danielfu11/exoseat/ProjectPlanning/Diagrams/Architecture_Diagram.jpg

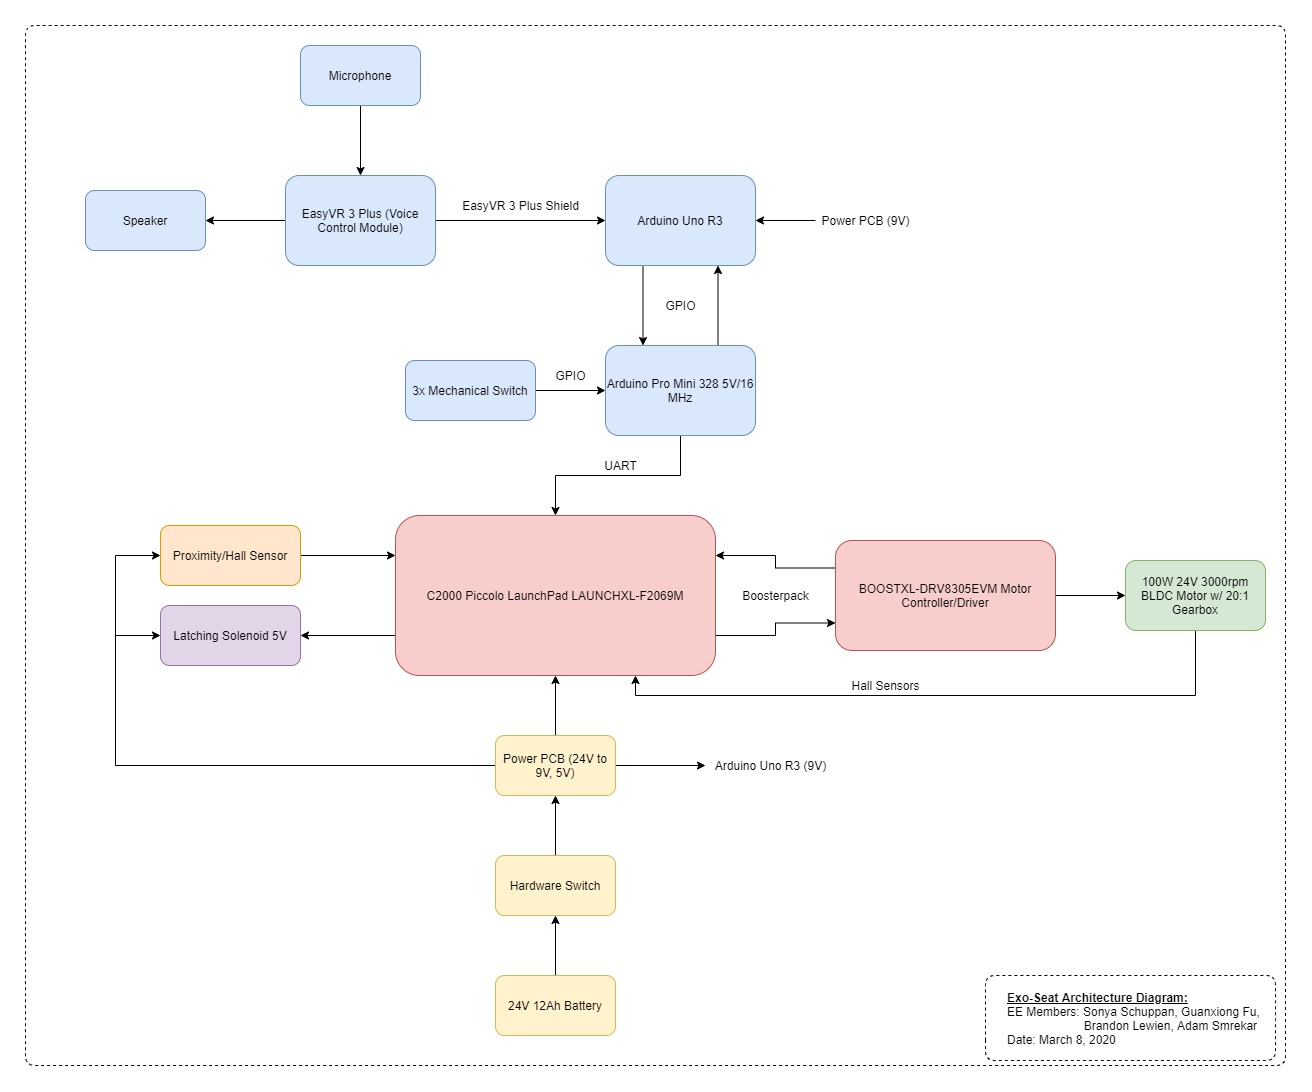
ProjectPlanning/Diagrams/Architecture_Diagram.jpg
