danielfu11/exoseat/ProjectPlanning/Diagrams/SystemStateMachine.PNG

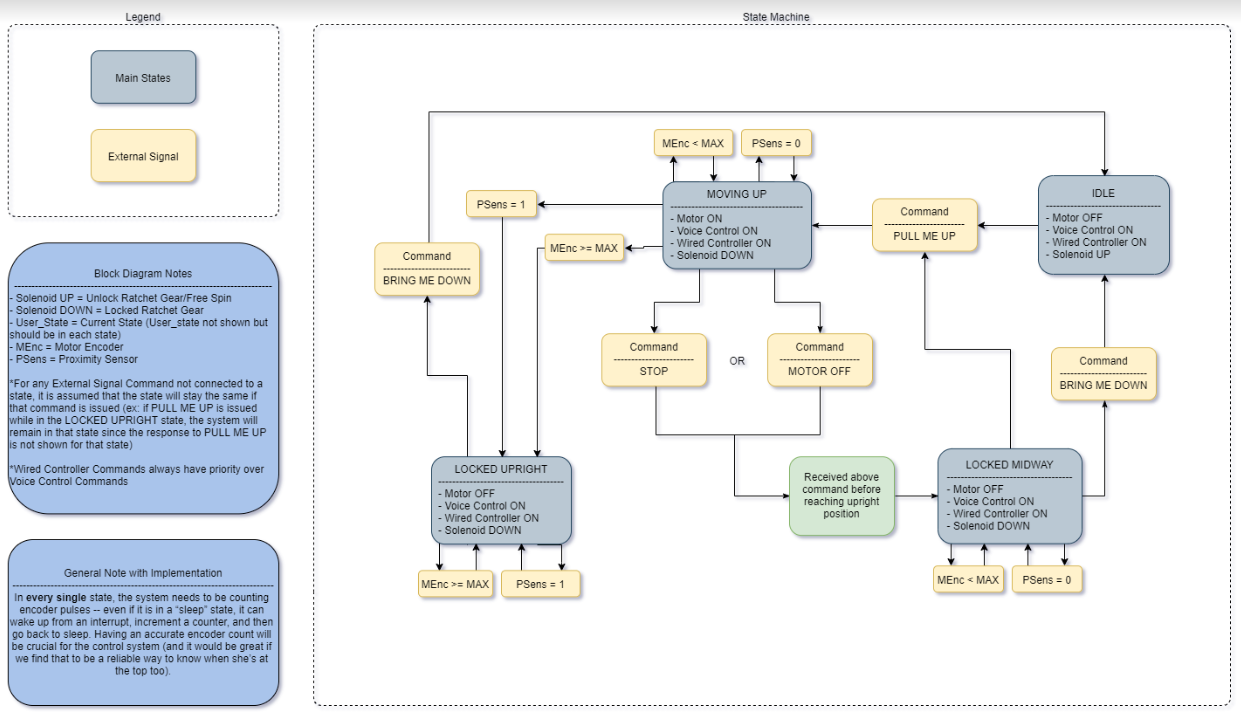
ProjectPlanning/Diagrams/SystemStateMachine.PNG
