danielfu11/exoseat/ProjectPlanning/Diagrams/TrapezoidalCommutationFlowDiagram.PNG

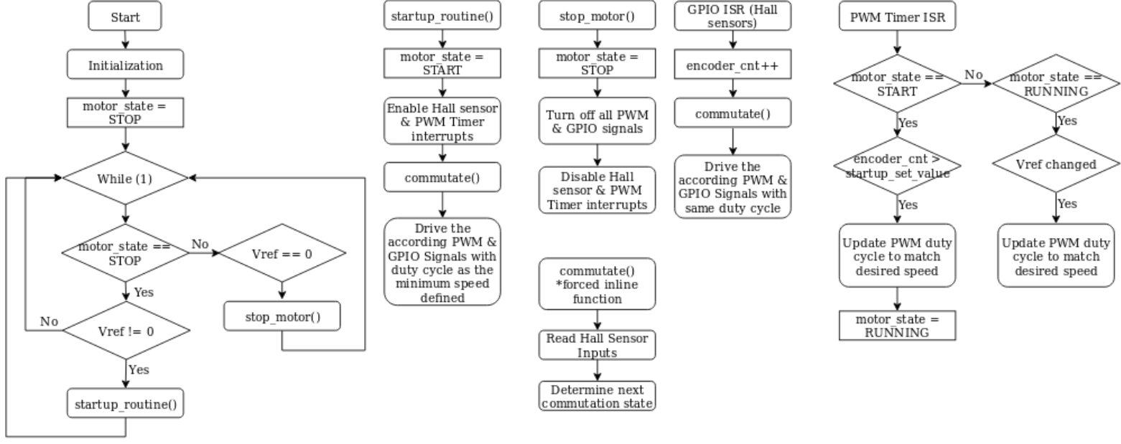
ProjectPlanning/Diagrams/TrapezoidalCommutationFlowDiagram.PNG
