danielfu11/exoseat/ProjectPlanning/Financial/Team_31_Budget_Tracker.xlsx

Sheet: ACTUAL
Design Center Colorado |  |  |  |  |  |  |  |  |  |  |  |  |  | yes | Procurement Card
Team Budget Tracker |  |  |  |  |  |  |  |  |  |  |  |  |  | no | Staff Member
 |  |  |  |  |  |  |  |  |  |  |  |  |  |  | Reimbursement Request
 |  |  |  | Funding Total |  |  |  |  |  |  |  |  |  |  | Campus labs
 |  |  |  | CU Provided | $324.00
Team #: | 31 |  |  | Initial Funding | $200.00
Sponsor: | Tensentric |  |  | Subsequent Funding | $2109.00
Financial Manager: | Adam Smrekar |  |  | Other Funding Sources
Budget Remaining: | $51.55
Sponsor Total Purchased: | $818.66
Project Total Spent: | $3166.90
Date of Purchase | Amount | Which funds? | Vendor | Brief description of item (s) purchased | Business Purpose - Please be detailed. i.e. How does this purchase benefit your project? What will the item be used for? | Website (If applicable) | Purchased via Pcard, Staff Member, in campus labs, or Reimbursement? | Discount/Donation provided by sponsor or vendor? Explain | Receipt Attached to Concur? | If Unit >$150, Budget Justification Uploaded to D2L? | Any tax charged? | What Section was it in the 'BUDGET' tab? | Notes
2019-10-07 | $27.99 | EEF | Amazon | Leamai Inflatable Posture Brace. Inflatable posture corrector back brace. Medical device to correct posture for upper back and shoulders. | Allows us to prototype a potential back support solution for our client Cindy. This is a cost effective and practical solution to help with back support for our client who sits in a wheelchair all day. | https://www.amazon.com/Inflatable-Posture-Corrector-Pressure-Shoulders/dp/B077XQ2M1W | Staff Member | N/A | No | N/A | No | Testing
2019-10-07 | $23.97 | EEF | eBay | Back and shoulder posture correction brace. Has two high-strength support plates. Has X-shaped cross adjustment correction belt. | Allows us to prototype a potential back support solution for our client Cindy. This is a cost effective and practical solution to help with back support for our client who sits in a wheelchair all day. | https://www.ebay.com/itm/Back-Posture-Correction-Shoulder-Corrector-Support-Brace-Belt-Therapy-Men-Women-/303081311477 | Staff Member | N/A | No | N/A | No | Testing
2019-10-07 | $18.54 | EEF | Home Depot | 2x 3 in. Zinc-Plated Fixed Single Pulley | Our design for the wheelchair involves attaching a harness with a rope(or other) to a motor with 2 pulleys. These pulleys will be used for prototyping. | https://www.homedepot.com/p/National-Hardware-3-in-Zinc-Plated-Fixed-Single-Pulley-N220-020/204722014 | Staff Member | N/A | No | N/A | No | Testing
2019-10-07 | $8.95 | EEF | Sparkfun | Flex Sensor. Function of this sensor is when the sensor is flexed, the resistance across the sensor increases. | Prototype option for giving feedback of when and how much client has fallen forward in the chair. Would be used on back. This will allow for better control over the electrical system. | https://www.sparkfun.com/products/10264 | Staff Member | N/A | No | N/A | No | Testing
2019-10-07 | $8.50 | EEF | Sparkfun | Straight bar load cell (also known as strain gauge). Able to translate up to 10kg of force on the straight bar into an electrical signal. | Prototype option for figuring out the amount of force a client is applying to the harness. A potential prototype like this will be used to give feedback about what is going on with the client in the harness to help better control the electrical system. | https://www.sparkfun.com/products/13329 | Staff Member | N/A | No | N/A | No | Testing
2019-10-07 | $15.95 | EEF | Sparkfun | 9 Degrees of Freedom IMU. Motion-sensing system-in-a-chip. Houses a 3-axis accelerometer, 3-axis gyroscope, and 3-axis magnetometer. | Prototype option to allow for feedback of what the client is doing to the harness. Allows for better control of the electrical system. | https://www.sparkfun.com/products/13284 | Staff Member | N/A | No | N/A | No | Testing
2019-10-07 | $12.95 | EEF | Sparkfun | Wheel Encoder Kit. Add-on to a wheel to help measure speed or distance. | Allows us to control how many rotations the motor should do when the motor is helping pull the client back into the correct position or to away from the correct position. | https://www.sparkfun.com/products/12629 | Staff Member | N/A | No | N/A | No | Testing
2019-10-15 | $4.75 | EEF | Sparkfun | Hall-Effect non-latched sensor. Holding a magnet near the sensor will cause the output pin to toggle. | Will be used to detect when the harness is at the top of the wheel chair. | https://www.sparkfun.com/products/14709 | Staff Member | N/A | No | N/A | No | Testing
2019-10-26 | $11.99 | EEF | Amazon | Protoboards. 36 pieces double sided PCB prototype boards in 5 different sizes. | Used for as the board to test out electrical circuits with various functions like the motor driver | https://www.amazon.com/AUSTOR-Prototype-Universal-Protoboard-Electronic/dp/B074X2GDH2 | Procurement Card | N/A | Yes | N/A | No | Testing
2019-10-25 | $38.29 | EEF | 18650 Battery Store | Bason BO-4 Battery Charger. 4 bay compact battery charger | Needed to charge batteries | https://www.18650batterystore.com/Basen-p/basen-bo-4.htm | Procurement Card | 5% Off, discount code | Yes | N/A | No | Testing
2019-10-25 | $70.28 | EEF | Arrow | FIT0185 Brushless DC Motor. Metal DC Geared Motor w/Encoder | Used for prototyping. Having motors is a key part of our design. | https://www.arrow.com/en/products/fit0185/dfrobot | Procurement Card | Discount code | Yes | N/A | No | Testing
2019-10-30 | $19.00 | EEF | Sparkfun | N-Channel MOSFET 60V 30A | Used for motor driver circuit. | https://www.sparkfun.com/products/10213 | Procurement Card | N/A | Yes | N/A | No | Testing
2019-10-30 | $1.95 | EEF | Sparkfun | Jumper Wires - Connected 6" (M/F, 20 Pack) | Wires used for electrical circuits. Will be used for testing. | https://www.sparkfun.com/products/12794 | Procurement Card | N/A | Yes | N/A | No | Testing
2019-10-30 | $1.95 | EEF | Sparkfun | Jumper Wires - Connected 6" (M/M, 20 Pack) | Wires used for electrical circuits. Will be used for testing. | https://www.sparkfun.com/products/12795 | Procurement Card | N/A | Yes | N/A | No | Testing
2019-10-30 | $1.95 | EEF | Sparkfun | Jumper Wires - Connected 6" (F/F, 20 Pack) | Wires used for electrical circuits. Will be used for testing. | https://www.sparkfun.com/products/12796 | Procurement Card | N/A | Yes | N/A | No | Testing
2019-11-07 | $18.95 | EEF | McMaster-Carr | L Series Timing Belt | Used as the timing belt for the gears in motor box. | https://www.mcmaster.com/6484k146 | Procurement Card | N/A | Yes | N/A | No | Testing
2019-11-08 | $44.51 | EEF | Misumi | Rotary shaft – straight | Used in the gear/motor box. | https://us.misumi-ec.com/vona2/detail/110300086920/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 | Procurement Card | N/A | Yes | N/A | No | Testing
2019-11-08 | $59.92 | EEF | Misumi | Idler Pulleys - Flat - Flanged | Pulleys used to hold the straps. | https://us.misumi-ec.com/vona2/detail/110300412670/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 | Procurement Card | N/A | Yes | N/A | No | Testing
2019-11-08 | $36.79 | EEF | Digikey | Solenoid Push Pulse 5V (Latching) | Need a way of releasing the harness/straps from ratchet so a potential option is to use a latching solenoid to allow harness to free spin or stay in place. | https://www.digikey.com/product-detail/en/delta-electronics/DSMS-0730-05/1144-1315-ND/5214006 | Procurement Card | N/A | Yes | N/A | No | Testing
2019-11-14 | $49.95 | EEF | Sparkfun | EasyVR 3 Plus Shield for Arduino. Voice recognition with the EasyVR 3 Plus Module, Arduino Shield Adapter, Microphone, and headers. | One of the potential voice control modules that the user will use to interact with the electrical parts of the project. | https://www.sparkfun.com/products/15453 | Procurement Card | N/A | Yes | N/A | No | Testing
Iteration 1
2019-12-28 | $5.84 | EEF | McMaster-Carr | T-Slotted Framing, Single 4-Slot Rail, Silver, 1" High x 1" Wide, Solid, 1' Long | Used for motor box housing. Motor box holds all the main components for this project. | https://www.mcmaster.com/47065t101-47065T411 | Procurement Card | N/A | Yes | N/A | No | Iteration 1/Manufacturing
2019-12-28 | $20.84 | EEF | McMaster-Carr | Silver Corner Bracket, 1" Long for 1" High Rail T-Slotted Framing | Used for motor box housing. Motor box holds all the main components for this project. | https://www.mcmaster.com/47065t236 | Procurement Card | N/A | Yes | N/A | No | Iteration 1/Manufacturing
2019-12-28 | $23.00 | EEF | McMaster-Carr | T-Slotted Framing, End-Feed Nut with Flanged-Button Head, 1/4"-20 Thread Size, Packs of 4 | Used for motor box housing. Motor box holds all the main components for this project. | https://www.mcmaster.com/47065t142 | Procurement Card | N/A | Yes | N/A | No | Iteration 1/Manufacturing
2019-12-28 | $46.42 | EEF | McMaster-Carr | Multipurpose 6061 Aluminum 90 Degree Angle with Round Edge, 1/4" Thickness, 4" High x 4" Wide Outside, 1' Long | Used for motor box housing. Motor box holds all the main components for this project. | https://www.mcmaster.com/8982k63-8982K631 | Procurement Card | N/A | Yes | N/A | No | Iteration 1/Manufacturing
2019-12-28 | $6.79 | EEF | McMaster-Carr | 7 Piece Ball-End Hex L-Key Set | Tools to screw in hex screws | https://www.mcmaster.com/5709a51 | Procurement Card | N/A | Yes | N/A | No | Iteration 1/Manufacturing
2019-12-28 | $10.38 | EEF | McMaster-Carr | L Series Timing Belt, Trade No. 150L050 | Used in motor box. Used between gears of motor and a shaft that holds rope. | https://www.mcmaster.com/6484k145 | Procurement Card | N/A | Yes | N/A | No | Iteration 1/Manufacturing
2019-12-28 | $0.95 | EEF | McMaster-Carr | Multipurpose 6061 Aluminum, 1/8" Thick x 1" Wide, 1/2 Feet Long | Used in/for motor box. Motor box holds all the main components for this project. | https://www.mcmaster.com/8975k578 | Procurement Card | N/A | Yes | N/A | No | Iteration 1/Manufacturing
2019-12-28 | $0.80 | EEF | McMaster-Carr | Light Duty Dry-Running Nylon Sleeve Bearing for 1/4" Shaft Diameter and 3/8" Housing ID, 1/2" Long | Used in/for motor box. Motor box holds all the main components for this project. | https://www.mcmaster.com/6389k113 | Procurement Card | N/A | Yes | N/A | No | Iteration 1/Manufacturing
2019-12-28 | $27.22 | EEF | McMaster-Carr | Rotary Shaft, 303 Stainless Steel, 1/2" Diameter, 12" Long | Used in/for motor box. Motor box holds all the main components for this project. | https://www.mcmaster.com/8364t5 | Procurement Card | N/A | Yes | N/A | No | Iteration 1/Manufacturing
2019-12-28 | $5.03 | EEF | McMaster-Carr | Easy-to-Machine 303 Stainless Steel Bar, 1/8" Thick, 1/2" Wide, 1/2 Feet Long | Used in/for motor box. Motor box holds all the main components for this project. | https://www.mcmaster.com/9084k96-9084K969 | Procurement Card | N/A | Yes | N/A | No | Iteration 1/Manufacturing
2019-12-28 | $18.88 | EEF | McMaster-Carr | Oil-Embedded SAE 841 Bronze Sleeve Bearing for 15 mm Shaft Diameter and 19 mm Housing ID, 16 mm Long | Used in/for motor box. Motor box holds all the main components for this project. | https://www.mcmaster.com/6658k27 | Procurement Card | N/A | Yes | N/A | No | Iteration 1/Manufacturing
2019-12-28 | $10.14 | EEF | McMaster-Carr | Shipping | Shipping |  | Procurement Card | N/A | Yes | N/A | No | Iteration 1/Manufacturing | Order was originally charged with tax. I had that order refunded and a new invoice was made without tax.
2019-12-28 | $29.21 | EEF | Misumi | Shaft Collars - D Shape, Split 1-1/4" | Used to hold motor box. Motor box holds all the main components for this project. | U-SSCDN1.25 | Procurement Card | N/A | Yes | N/A | No | Iteration 1/Manufacturing
2019-12-28 | $51.90 | EEF | Misumi | Shaft Collars - D Shape, Split 1" | Used to hold motor box. Motor box holds all the main components for this project. | U-SSCDN1.00 | Procurement Card | N/A | Yes | N/A | No | Iteration 1/Manufacturing
2019-12-28 | $32.32 | EEF | Misumi | Shaft Collars - D Shape, 10 mm | Used to hold motor box. Motor box holds all the main components for this project. | SDNA10 | Procurement Card | N/A | Yes | N/A | No | Iteration 1/Manufacturing
2019-12-28 | $41.52 | EEF | Misumi | Shaft Collars - D Shape, 20 mm | Used to hold motor box. Motor box holds all the main components for this project. | SDNA20 | Procurement Card | N/A | Yes | N/A | No | Iteration 1/Manufacturing
2019-12-28 | $48.04 | EEF | Misumi | Both Ends Threaded Precision Linear Shaft | Used in/for motor box. Motor box holds all the main components for this project. | SFAM15-50-F15-B10-P12-T15-S10-Q12 | Procurement Card | N/A | Yes | N/A | No | Iteration 1/Manufacturing
2020-01-09 | $29.21 | EEF | Misumi | Shaft Collars - D Shape, Split 1-1/4" | Used to hold motor box. Motor box holds all the main components for this project. | U-SSCDN1.25 | Procurement Card | N/A | No | N/A | No | Iteration 1/Manufacturing | This part was in 2 seperate orders due to 1 in-stock at the time of original order
2019-12-28 | $23.09 | EEF | Misumi | Shipping | Shipping |  | Procurement Card | N/A | Yes | N/A | No | Iteration 1/Manufacturing
2019-12-28 | $12.19 | EEF | Misumi | Shipping | Shipping |  | Procurement Card | N/A | Yes | N/A | No | Iteration 1/Manufacturing | Since some products were shipped from different locations, they split the price of shipping
2020-01-09 | $25.54 | EEF | Misumi | Shipping | Shipping |  | Procurement Card | N/A | No | N/A | No | Iteration 1/Manufacturing
2019-12-28 | $58.24 | EEF | Midwest Steel and Aluminum | Metal Plates -> || 6061 T6 ALUMINUM SHEET .125: W: 12" L: 12" || || 6061 T6 ALUMINUM SHEET .125: W: 11.5625" L: 11.5625" || || 6061 T6 ALUMINUM SHEET .125: W: 4.5625" L: 11.5625" || || 6061 T6 ALUMINUM SHEET .125: W: 3.5625" L: 11.5625" || | Used in/for motor box. Motor box holds all the main components for this project. | https://www.midweststeelsupply.com/store/6061aluminumsheet | Procurement Card | N/A | Yes | N/A | No | Iteration 1/Manufacturing | Issues with getting billing address on the invoice. Account had correct billing address. Didn't receive invoice until requested and found out about this issue and they wouldn't change it saying the order is closed.
2019-12-28 | $11.64 | EEF | Midwest Steel and Aluminum | Shipping | Shipping |  | Procurement Card | N/A | Yes | N/A | No | Iteration 1/Manufacturing
2019-12-30 | $37.44 | EEF | sdp-si | 440C Stainless Steel/ABEC 3 Ball Bearing Lubricated with Oil | Used in/for motor box. Motor box holds all the main components for this project. | http://shop.sdp-si.com/catalog/product/?id=A%207Y55-P11250 | Procurement Card | N/A | Yes | N/A | No | Iteration 1/Manufacturing
2019-12-30 | $31.92 | EEF | sdp-si | 1/2 in. ID, 3-29/32 in. High Standard Duty Set Screw Type Diamond Flange Mounting Block | Used in/for motor box. Motor box holds all the main components for this project. | http://shop.sdp-si.com/catalog/product/?id=BBXBLK-UFL2018S | Procurement Card | N/A | Yes | N/A | No | Iteration 1/Manufacturing | Invoice has name Designatronics Inc instead of SDP-SI
2019-12-30 | $23.93 | EEF | sdp-si | Shipping | Shipping |  | Procurement Card | N/A | Yes | N/A | No | Iteration 1/Manufacturing | For billing address on invoice, it can't have the correct attn. It uses Company Name instead
2019-12-29 | $31.04 | EEF | Online Metals | Bearing Housing -> || 0.75" x 5" Aluminum Rectangle Bar 6061-T6511-Extruded: Thickness: 0.75", Width: 5", Size: 4.5" || | Used in/for motor box. Motor box holds all the main components for this project. | https://www.onlinemetals.com/en/buy/aluminum-rectangle-bar-6061-t6511-extruded?checkbox=on&sort=name-asc | Procurement Card | N/A | Yes | N/A | No | Iteration 1/Manufacturing
2019-12-29 | $10.00 | EEF | Online Metals | Shipping | Shipping |  | Procurement Card | N/A | Yes | N/A | No | Iteration 1/Manufacturing
2020-01-09 | $19.93 | EEF | Grainger | Shaft Extender Kit,For Use With 1/2" Dia. Motor Shafts | Attaches to the motor | https://www.grainger.com/product/12N975?RIID=54198286875&GID=&mid=EMT-_-10339122-_-OrderConfirmation-_-Item | Procurement Card | N/A | Yes | N/A | No | Iteration 1/Manufacturing
2020-01-09 | $0.00 | EEF | Grainger | Shipping | Shipping |  | Procurement Card | N/A | Yes | N/A | No | Iteration 1/Manufacturing
2020-01-31 | $10.19 | EEF | McMaster-Carr | D-Profile Rotary Shaft, D-Profile Ends, 1045. Carbon Steel, 1/2" Diameter, 12" Long | Used in/for motor box. Motor box holds all the main components for this project. | https://www.mcmaster.com/8632t7 | Procurement Card | N/A | Yes | N/A | No | Iteration 1/Manufacturing
2020-01-31 | $7.31 | EEF | McMaster-Carr | D-Profile Rotary Shaft, D-Profile Ends, 1045 Carbon Steel, 1/2" Diameter, 6" Long | Used in/for motor box. Motor box holds all the main components for this project. | https://www.mcmaster.com/8632t134 | Procurement Card | N/A | No | N/A | No | Iteration 1/Manufacturing | Not Currently Payed because Misumi double charged and made the balance of the order go low
2020-01-31 | $8.39 | EEF | McMaster-Carr | Shipping | Shipping |  | Procurement Card | N/A | No | N/A | No | Iteration 1/Manufacturing
 | $0.00 |  |  |  |  |  | Procurement Card |  |  |  |  | Iteration 1/Manufacturing
2019-12-23 | $610.27 | EEF | ato | 100W 24V 3000rpm BLDC Motor w/ 20:1 Planetary Gearbox and 100W 24V 3000rpm BLDC Motor | Used to allow user's torso to move different positions in the wheelchair. | https://www.ato.com/100w-bldc-motor | Procurement Card | 5% Discount | Yes | Yes | No | Iteration 1/Manufacturing
2019-12-23 | $106.00 | EEF | ato | Custom: Gearbox output shaft length of 25mm and shaft diameter of 0.5 ”(12.97mm) for above motor with planetary gearbox | Custom part for motor w/ gearbox to fit necessary dimensions |  | Procurement Card | N/A | Yes | Yes | No | Iteration 1/Manufacturing | Since this was a custom part, they charged extra for original purchase. This is tied with the order of both of ATO's Brushless DC Motors. On invoice, there is a charge and a partial refund due to we not needing another extra custom part.
2019-12-23 | $0.00 | EEF | ato | Shipping | Shipping |  | Procurement Card | N/A | Yes | N/A | No | Iteration 1/Manufacturing
2019-12-27 | $298.90 | EEF | BixPower | 24V 12Ah Lithium Ion Battery | Used to power the electrical system | https://www.bixpower.com/24V-10-4Ah-Battery-BX2493H-p/bat-bx2493h.htm | Procurement Card | N/A | Yes | Yes | No | Iteration 1/Manufacturing
2019-12-27 | $16.08 | EEF | BixPower | Shipping | Shipping |  | Procurement Card | N/A | Yes | N/A | No | Iteration 1/Manufacturing
2020-01-09 | $27.80 | EEF | Digikey | Solenoid Push Pulse 5V (Latching) | Need a way of releasing the harness/straps from ratchet so a potential option is to use a latching solenoid to allow harness to free spin or stay in place. | https://www.digikey.com/product-detail/en/delta-electronics/DSMS-0730-05/1144-1315-ND/5214006 | Procurement Card | N/A | Yes | N/A | No | Iteration 1/Manufacturing
2020-01-09 | $0.88 | EEF | Digikey | CAP, CERM, 1 µF, 16 V, +/- 10%, X7R, 0603 | Used for custom circuit motor driver. Motor driver interfaces between circuit and motor. Part of EE Capstone requirement is to have a custom PCB, so we chose this circuit to do. | https://www.digikey.com/product-detail/en/kemet/C0603C105K4RACTU/399-7847-1-ND/3471570 | Procurement Card | N/A | Yes | N/A | No | Iteration 1/Manufacturing
2020-01-09 | $3.04 | EEF | Digikey | CAP, CERM, 0.047uF, 100V, +/-10%, X7R, 0603 | Used for custom circuit motor driver. Motor driver interfaces between circuit and motor. | https://www.digikey.com/product-detail/en/kemet/C0603C473K1RACTU/399-9096-1-ND/3522613 | Procurement Card | N/A | Yes | N/A | No | Iteration 1/Manufacturing
2020-01-09 | $8.75 | EEF | Digikey | CAP, CERM, 1 µF, 50 V, +/- 10%, X7R, 0603 | Used for custom circuit motor driver. Motor driver interfaces between circuit and motor. | https://www.digikey.com/product-detail/en/taiyo-yuden/UMK107AB7105KA-T/587-3247-6-ND/3660108 | Procurement Card | N/A | Yes | N/A | No | Iteration 1/Manufacturing
2020-01-09 | $12.79 | EEF | Digikey | CAP, CERM, 4.7 µF, 50 V, +/- 10%, X7R, 1206 | Used for custom circuit motor driver. Motor driver interfaces between circuit and motor. | https://www.digikey.com/product-detail/en/murata-electronics/GRM31CR71H475KA12L/490-6521-6-ND/3846734 | Procurement Card | N/A | Yes | N/A | No | Iteration 1/Manufacturing
2020-01-09 | $1.00 | EEF | Digikey | CAP, CERM, 0.1 µF, 16 V, +/- 5%, X7R, 0603 | Used for custom circuit motor driver. Motor driver interfaces between circuit and motor. | https://www.digikey.com/product-detail/en/kemet/C0603C104J4RACTU/399-1097-1-ND/411372 | Procurement Card | N/A | Yes | N/A | No | Iteration 1/Manufacturing
2020-01-09 | $0.41 | EEF | Digikey | CAP, CERM, 1000pF, 16V, +/-10%, X7R, 0603 | Used for custom circuit motor driver. Motor driver interfaces between circuit and motor. | https://www.digikey.com/product-detail/en/walsin-technology-corporation/0603B102K160CT/1292-1378-1-ND/9355382 | Procurement Card | N/A | Yes | N/A | No | Iteration 1/Manufacturing
2020-01-09 | $14.55 | EEF | Digikey | CAP, CERM, 2.2 µF, 100 V, +/- 10%, X7R, 1210 | Used for custom circuit motor driver. Motor driver interfaces between circuit and motor. | https://www.digikey.com/product-detail/en/murata-electronics/GRM32ER72A225KA35L/490-3385-1-ND/702926 | Procurement Card | N/A | Yes | N/A | No | Iteration 1/Manufacturing
2020-01-09 | $8.59 | EEF | Digikey | CAP, AL, 330 µF, 50 V, +/- 20%, 0.3 ohm, SMD | Used for custom circuit motor driver. Motor driver interfaces between circuit and motor. | https://www.digikey.com/product-detail/en/panasonic-electronic-components/EEE-FT1H331AP/PCE5026CT-ND/2652081 | Procurement Card | N/A | Yes | N/A | No | Iteration 1/Manufacturing
2020-01-09 | $9.32 | EEF | Digikey | CAP, CERM, 22 µF, 10 V, +/- 10%, X7R, 1206 | Used for custom circuit motor driver. Motor driver interfaces between circuit and motor. | https://www.digikey.com/product-detail/en/murata-electronics/GRM31CR71A226KE15L/490-5309-1-ND/2039088 | Procurement Card | N/A | Yes | N/A | No | Iteration 1/Manufacturing
2020-01-09 | $0.55 | EEF | Digikey | CAP, CERM, 2200pF, 16V, +/-10%, X7R, 0603 | Used for custom circuit motor driver. Motor driver interfaces between circuit and motor. | https://www.digikey.com/product-detail/en/yageo/CC0603KRX7R7BB222/311-3652-1-ND/8024741 | Procurement Card | N/A | Yes | N/A | No | Iteration 1/Manufacturing
2020-01-09 | $1.35 | EEF | Digikey | CAP, CERM, 0.33 µF, 16 V, +/- 10%, X7R, 0603 | Used for custom circuit motor driver. Motor driver interfaces between circuit and motor. | https://www.digikey.com/product-detail/en/murata-electronics/GRM188R71C334KA01D/490-3294-1-ND/702835 | Procurement Card | N/A | Yes | N/A | No | Iteration 1/Manufacturing
2020-01-09 | $2.41 | EEF | Digikey | LED, Red, SMD | Used for custom circuit motor driver. Motor driver interfaces between circuit and motor. | https://www.digikey.com/product-detail/en/lite-on-inc/LTST-C170KRKT/160-1415-1-ND/386778 | Procurement Card | N/A | Yes | N/A | No | Iteration 1/Manufacturing
2020-01-09 | $4.58 | EEF | Digikey | Transient Voltage Suppressors, 5 V, TSOP-6 | Used for custom circuit motor driver. Motor driver interfaces between circuit and motor. | https://www.digikey.com/product-detail/en/on-semiconductor/NUP2201MR6T1G/NUP2201MR6T1GOSCT-ND/720939 | Procurement Card | N/A | Yes | N/A | No | Iteration 1/Manufacturing
2020-01-09 | $2.01 | EEF | Digikey | LED, Green, SMD | Used for custom circuit motor driver. Motor driver interfaces between circuit and motor. | https://www.digikey.com/product-detail/en/lite-on-inc/LTST-C171GKT/160-1423-1-ND/386792 | Procurement Card | N/A | Yes | N/A | No | Iteration 1/Manufacturing
2020-01-09 | $3.86 | EEF | Digikey | Diode, Schottky, 100 V, 1 A, SOD-123FL | Used for custom circuit motor driver. Motor driver interfaces between circuit and motor. | https://www.digikey.com/product-detail/en/on-semiconductor/MBR1H100SFT3G/MBR1H100SFT3GOSCT-ND/3462287 | Procurement Card | N/A | Yes | N/A | No | Iteration 1/Manufacturing
2020-01-09 | $3.22 | EEF | Digikey | Terminal Block, 5 mm, 2x1, Tin, TH | Used for custom circuit motor driver. Motor driver interfaces between circuit and motor. | https://www.digikey.com/products/en?keywords=TB001-500-02BE | Procurement Card | N/A | Yes | N/A | No | Iteration 1/Manufacturing
2020-01-09 | $4.31 | EEF | Digikey | Terminal Block, 5 mm, 3x1, Tin, TH | Used for custom circuit motor driver. Motor driver interfaces between circuit and motor. | https://www.digikey.com/products/en?keywords=TB001-500-03BE | Procurement Card | N/A | Yes | N/A | No | Iteration 1/Manufacturing
2020-01-09 | $11.10 | EEF | Digikey | Inductor, Shielded Drum Core, Ferrite, 15 µH, 1.1 A, 0.122 ohm, SMD | Used for custom circuit motor driver. Motor driver interfaces between circuit and motor. | https://www.digikey.com/product-detail/en/eaton-electronics-division/SD53-150-R/513-1458-1-ND/1555607 | Procurement Card | N/A | Yes | N/A | No | Iteration 1/Manufacturing
2020-01-09 | $27.06 | EEF | Digikey | MOSFET, N-CH, 60 V, 28 A, SON 5x6mm | Used for custom circuit motor driver. Motor driver interfaces between circuit and motor. | https://www.digikey.com/product-detail/en/texas-instruments/CSD18540Q5B/296-41076-1-ND/5181337 | Procurement Card | N/A | Yes | N/A | No | Iteration 1/Manufacturing
2020-01-09 | $0.31 | EEF | Digikey | RES, 10k ohm, 5%, 0.1W, 0603 | Used for custom circuit motor driver. Motor driver interfaces between circuit and motor. | https://www.digikey.com/product-detail/en/vishay-dale/CRCW060310K0JNEA/541-10KGCT-ND/1179393 | Procurement Card | N/A | Yes | N/A | No | Iteration 1/Manufacturing
2020-01-09 | $0.31 | EEF | Digikey | RES, 100 ohm, 5%, 0.1W, 0603 | Used for custom circuit motor driver. Motor driver interfaces between circuit and motor. | https://www.digikey.com/product-detail/en/vishay-dale/CRCW0603100RJNEA/541-100GCT-ND/1179345 | Procurement Card | N/A | Yes | N/A | No | Iteration 1/Manufacturing
2020-01-09 | $6.68 | EEF | Digikey | RES SMD 0.007 OHM 1% 3W 2512 | Used for custom circuit motor driver. Motor driver interfaces between circuit and motor. | https://www.digikey.com/product-detail/en/bourns-inc/CRE2512-FZ-R007E-3/CRE2512-FZ-R007E-3CT-ND/4900096 | Procurement Card | N/A | Yes | N/A | No | Iteration 1/Manufacturing
2020-01-09 | $0.31 | EEF | Digikey | RES, 330 ohm, 5%, 0.1W, 0603 | Used for custom circuit motor driver. Motor driver interfaces between circuit and motor. | https://www.digikey.com/product-detail/en/vishay-dale/CRCW0603330RJNEA/541-330GCT-ND/1179357 | Procurement Card | N/A | Yes | N/A | No | Iteration 1/Manufacturing
2020-01-09 | $0.23 | EEF | Digikey | RES, 62.0 k, 1%, 0.1 W, 0603 | Used for custom circuit motor driver. Motor driver interfaces between circuit and motor. | https://www.digikey.com/product-detail/en/yageo/RC0603FR-0762KL/311-62.0KHRCT-ND/730283 | Procurement Card | N/A | Yes | N/A | No | Iteration 1/Manufacturing
2020-01-09 | $0.23 | EEF | Digikey | RES, 4.99 k, 1%, 0.1 W, 0603 | Used for custom circuit motor driver. Motor driver interfaces between circuit and motor. | https://www.digikey.com/product-detail/en/yageo/RC0603FR-074K99L/311-4.99KHRCT-ND/730166 | Procurement Card | N/A | Yes | N/A | No | Iteration 1/Manufacturing
2020-01-09 | $0.31 | EEF | Digikey | RES, 56 ohm, 5%, 0.1W, 0603 | Used for custom circuit motor driver. Motor driver interfaces between circuit and motor. | https://www.digikey.com/product-detail/en/vishay-dale/CRCW060356R0JNEA/541-56GCT-ND/1179339 | Procurement Card | N/A | Yes | N/A | No | Iteration 1/Manufacturing
2020-01-09 | $0.23 | EEF | Digikey | RES, 68.0 k, 1%, 0.1 W, 0603 | Used for custom circuit motor driver. Motor driver interfaces between circuit and motor. | https://www.digikey.com/product-detail/en/yageo/RC0603FR-0768KL/311-68.0KHRCT-ND/730299 | Procurement Card | N/A | Yes | N/A | No | Iteration 1/Manufacturing
2020-01-09 | $0.34 | EEF | Digikey | RES, 20.0 k, 1%, 0.1 W, 0603 | Used for custom circuit motor driver. Motor driver interfaces between circuit and motor. | https://www.digikey.com/product-detail/en/vishay-dale/CRCW060320K0FKEA/541-20.0KHCT-ND/1179956 | Procurement Card | N/A | Yes | N/A | No | Iteration 1/Manufacturing
2020-01-09 | $23.80 | EEF | Digikey | Three Phase Automotive Gate Driver with Three Integrated Current Shunt Amplifiers and Voltage Regulator, PHP0048G | Used for custom circuit motor driver. Motor driver interfaces between circuit and motor. | https://www.digikey.com/product-detail/en/texas-instruments/DRV83055QPHPRQ1/296-44256-1-ND/6109010 | Procurement Card | N/A | Yes | N/A | No | Iteration 1/Manufacturing
2020-01-09 | $11.52 | EEF | Digikey | Wide Input Voltage Range Buck Regulator with High Efficiency Sleep Mode, DDC0006A | Used for custom circuit motor driver. Motor driver interfaces between circuit and motor. | https://www.digikey.com/product-detail/en/texas-instruments/LMR16006XDDCR/296-40293-1-ND/5178170 | Procurement Card | N/A | Yes | N/A | No | Iteration 1/Manufacturing
2020-01-09 | $77.85 | EEF | Digikey | C2000 Piccolo LaunchPad LAUNCHXL-F2069M | Main microcontroller that we are using for this project. These are extra for each EE student to use and/or if any breaks during the development process. | https://www.digikey.com/product-detail/en/texas-instruments/LAUNCHXL-F28069M/296-38832-ND/5138373 | Procurement Card | N/A | Yes | N/A | No | Iteration 1/Manufacturing
2020-01-09 | $9.04 | EEF | Digikey | Tariff |  |  | Procurement Card | N/A | Yes | N/A | No | Iteration 1/Manufacturing
2020-01-09 | $8.99 | EEF | Digikey | Shipping |  |  | Procurement Card | N/A | Yes | N/A | No | Iteration 1/Manufacturing
2020-01-06 | $66.00 | EEF | PCBWay | FR-4 4 Layer Printed Circuit Board for Motor Driver | Custom circuit board to hold all the digikey parts listed above. | https://www.pcbway.com/ | Procurement Card | $5 discount | Yes | N/A | No | Iteration 1/Manufacturing
SPONSOR PROCURED (Fill out ONLY for items purchased on behalf of team directly through Sponsor - not pcard) Only for team tracking purposes. Does not need to be exact if procured on behalf of the team)
Date of Purchase | Amount |  | Vendor | Brief description of item (s) purchased | What Section was it in the 'BUDGET' tab? |  | Notes
2019-10-30 | $17.10 | Tensentric | McMaster Carr | 1/2" Drive Shaft | Testing (Possible Manufacturing) | https://www.mcmaster.com/1346k17
2019-10-30 | $16.28 | Tensentric | McMaster Carr | Aluminum Framing (5 ft) | Testing (Possible Manufacturing) | https://www.mcmaster.com/47065t101
2019-10-30 | $30.48 | Tensentric | McMaster Carr | Bracket for Framing | Testing (Possible Manufacturing) | https://www.mcmaster.com/47065t267
2019-10-30 | $23.00 | Tensentric | McMaster Carr | Framing Fasteners | Testing (Possible Manufacturing) | https://www.mcmaster.com/47065t142
2019-10-30 | $57.99 | Tensentric | McMaster Carr | Ratchet Gear | Testing (Possible Manufacturing) | https://www.mcmaster.com/6283k22
2019-10-30 | $48.48 | Tensentric | McMaster Carr | Pawl | Testing (Possible Manufacturing) | https://www.mcmaster.com/6283k32
2019-10-30 | $3.52 | Tensentric | McMaster Carr | Shoulder Screw - For Pawl | Testing (Possible Manufacturing) | https://www.mcmaster.com/91259a469
2019-10-30 | $4.90 | Tensentric | McMaster Carr | Wing Nut for Shoulder Screw | Testing (Possible Manufacturing) | https://www.mcmaster.com/98671a150
2019-10-30 | $12.30 | Tensentric | McMaster Carr | Shaft Collar Large | Testing (Possible Manufacturing) | https://www.mcmaster.com/9677t21
2019-10-30 | $21.90 | Tensentric | McMaster Carr | Bearing Blocks | Testing (Possible Manufacturing) | https://www.mcmaster.com/5913k61
2019-10-30 | $45.78 | Tensentric | McMaster Carr | Timing Belt Pulley | Testing (Possible Manufacturing) | https://www.mcmaster.com/1304n11
2019-10-30 | $9.37 | Tensentric | McMaster Carr | Timing Belt | Testing (Possible Manufacturing) | https://www.mcmaster.com/6484k144
2019-10-30 | $48.50 | Tensentric | McMaster Carr | Aluminum Side Wall (Sheet Metal) | Testing (Possible Manufacturing) | https://www.mcmaster.com/89015k238
2019-10-30 | $27.21 | Tensentric | McMaster Carr | Aluminum Base (Sheet Metal) | Testing (Possible Manufacturing) | https://www.mcmaster.com/89015k18
2019-10-30 | $6.46 | Tensentric | McMaster Carr | Rotary Spring (Variable Force) | Testing (Possible Manufacturing) | https://www.mcmaster.com/1846n3
2019-10-30 | $15.55 | Tensentric | Digikey | 3-Phase Brushless DC Mtr Driver | Testing (Possible Manufacturing) | https://www.digikey.com/product-detail/en/texas-instruments/DRV8313PWPR/296-40072-1-ND/5177949
2019-10-30 | $29.75 | Tensentric | Digikey | 3-Phase BLDC | Testing | https://www.digikey.com/product-detail/en/texas-instruments/DRV83053QPHPRQ1/296-44255-1-ND/6109009
2019-10-30 | $102.80 | Tensentric | Digikey | Motor Controller | Testing | https://www.digikey.com/products/en?mpart=DRV8313EVM&v=296
2019-11-08 | $64.00 | Tensentric | Flipsky | Motor BLDC | Testing | https://flipsky.net/collections/e-skateboard/products/brushless-dc-motor-h5065-200kv-1650w
Iteration 1
2020-01-16 | $10.92 | Tensentric | Mouser | PCB Headers 2.54mm, 10 Position, 2 Row | Iteration 1/Manufacturing | https://www.mouser.com/ProductDetail/Samtec/SSQ-110-23-F-D
2020-01-28 | $36.55 | Tensentric | Amazon | Back Brace Posture Corrector (XL size : 37" ~ 43") | Iteration 1/Manufacturing | https://www.amazon.com/Brace-Posture-Corrector-Black-Paker/dp/B07WFFNQQF
2020-01-28 | $19.99 | Tensentric | Amazon | Tcare Portable Inflatable Lumbar Support | Iteration 1/Manufacturing | https://www.amazon.com/Tcare-Portable-Inflatable-Support-Cushion/dp/B079BS995B?s=hpc
2020-01-28 | $17.16 | Tensentric | McMaster Carr | highly conductive 6101 aluminum bar: 3 ft length, ¾” width, ⅛” thickness | Iteration 1/Manufacturing | https://www.mcmaster.com/aluminum-bar-stock | 9397T11, 3 ft
2020-01-28 | $32.51 | Tensentric | McMaster Carr | highly conductive 6101 aluminum bar stock: 3 ft length, ¾” width, ¼” thickness | Iteration 1/Manufacturing | https://www.mcmaster.com/aluminum-bar-stock | 9397T12, 3 ft
2020-01-31 | $19.95 | Tensentric | Sparkfun | Pro-Micro 5V/16MHz | Iteration 1/Manufacturing | https://www.sparkfun.com/products/12640
2020-01-31 | $0.75 | Tensentric | Sparkfun | 1N4148 Diode | Iteration 1/Manufacturing | https://www.sparkfun.com/products/8588
2020-01-31 | $7.80 | Tensentric | Sparkfun | Cherry MX Switch Breakout | Iteration 1/Manufacturing | https://www.sparkfun.com/products/13773
2020-01-31 | $5.70 | Tensentric | Sparkfun | Cherry MX Blue Switch | Iteration 1/Manufacturing | https://www.sparkfun.com/products/13834
2020-02-04 | $13.27 | Tensentric | McMaster Carr | Shaft Coupler | Iteration 1/Manufacturing | https://www.mcmaster.com/2424k14
2020-02-04 | $11.68 | Tensentric | McMaster Carr | Aluminum Framing (1 ft) | Iteration 1/Manufacturing | https://www.mcmaster.com/47065t101-47065T411
2020-02-04 | $8.49 | Tensentric | McMaster Carr | M3 Tap | Iteration 1/Manufacturing | https://www.mcmaster.com/8305a12
2020-02-04 | $3.55 | Tensentric | McMaster Carr | Tapping Lubricant | Iteration 1/Manufacturing | https://www.mcmaster.com/1858k75
2020-02-04 | $22.66 | Tensentric | McMaster Carr | Mounting Bearings | Iteration 1/Manufacturing | https://www.mcmaster.com/5913k71
2020-02-04 | $2.00 | Tensentric | McMaster Carr | Key stock 4mm | Iteration 1/Manufacturing | https://www.mcmaster.com/92288a720
2020-02-04 | $2.41 | Tensentric | McMaster Carr | Key stock 5mm | Iteration 1/Manufacturing | https://www.mcmaster.com/92288a725
2020-02-04 | $11.40 | Tensentric | McMaster Carr | Hard Stop | Iteration 1/Manufacturing | https://www.mcmaster.com/3361t73
2020-02-04 | $6.50 | Tensentric | McMaster Carr | Webbing | Iteration 1/Manufacturing | https://www.mcmaster.com/8852t61-8852T416

Sheet: BUDGET
Purchase Plan
Team #: | 31
Sponsor: | Tensentric
Financial Manager: | Adam Smrekar
Team Budget:
Funding Sources:
CU Provided | 200
Other | 2433 | **Does not include funding from Tensentric**
Total Project Funding | 2633
Expense Summary
Phase 1: Testing | $673.83
Phase 2: Iteration 1/Manufacturing | $3152.61 | **Includes some extras that is funding used for all iterations**
Phase 3: Expo | $50.00
Client Interactions | $0.00
Contingency 7% | $271.35
Total Project Estimate | $4147.79
Phase 1: Testing
Item | Description | Vendor | Part No. | Website Link (optional) | Quantity | Price Per Unit | Shipping (Est) | Discount | Total (Est) | Status (i.e. ready, ordered, complete, etc) | Lead Time | Need by | Funded by
Leamai Inflatable Posture Brace | Inflatable posture corrector back brace. Medical device to correct posture for upper back and shoulders. | Amazon |  | https://www.amazon.com/Inflatable-Posture-Corrector-Pressure-Shoulders/dp/B077XQ2M1W | 1 | $22.00 | $5.99 | $0.00 | $27.99 | Complete |  | 2019-10-07 | EEF/CU
Back and shoulder posture correction brace | Has two high-strength support plates. Has X-shaped cross adjustment correction belt. | eBay |  | https://www.ebay.com/itm/Back-Posture-Correction-Shoulder-Corrector-Support-Brace-Belt-Therapy-Men-Women-/303081311477 | 1 | $10.98 | $12.99 | $0.00 | $23.97 | Complete |  | 2019-10-07 | EEF/CU
3 in. Zinc-Plated Fixed Single Pulley | 3 in. Zinc-Plated Fixed Single Pulley | Home Depot |  | https://www.homedepot.com/p/National-Hardware-3-in-Zinc-Plated-Fixed-Single-Pulley-N220-020/204722014 | 2 | $9.27 | $0.00 | $0.00 | $18.54 | Complete |  | 2019-10-07 | EEF/CU
Flex Sensor (2.2") | Function of this sensor is when the sensor is flexed, the resistance across the sensor increases. | Sparkfun |  | https://www.sparkfun.com/products/10264 | 1 | $8.95 | $0.00 | $0.00 | $8.95 | Complete |  | 2019-10-07 | EEF/CU
Straight bar load cell | Also known as strain gauge. Able to translate up to 10kg of force on the straight bar into an electrical signal. | Sparkfun |  | https://www.sparkfun.com/products/13329 | 1 | $8.50 | $0.00 | $0.00 | $8.50 | Complete |  | 2019-10-07 | EEF/CU
9 Degrees of Freedom IMU | Motion-sensing system-in-a-chip. Houses a 3-axis accelerometer, 3-axis gyroscope, and 3-axis magnetometer. | Sparkfun |  | https://www.sparkfun.com/products/13284 | 1 | $15.95 | $0.00 | $0.00 | $15.95 | Complete |  | 2019-10-07 | EEF/CU
Wheel Encoder Kit | Add-on to a wheel to help measure speed or distance. | Sparkfun |  | https://www.sparkfun.com/products/12629 | 1 | $12.95 | $0.00 | $0.00 | $12.95 | Complete |  | 2019-10-07 | EEF/CU
Hall-Effect non-latched sensor | Holding a magnet near the sensor will cause the output pin to toggle. | Sparkfun |  | https://www.sparkfun.com/products/14709 | 5 | $0.95 | $0.00 | $0.00 | $4.75 | Complete |  | 2019-10-15 | EEF/CU
Protoboards | 36 pieces double sided PCB prototype boards in 5 different sizes. | Amazon |  | https://www.amazon.com/AUSTOR-Prototype-Universal-Protoboard-Electronic/dp/B074X2GDH2 | 1 | $11.99 | $0.00 | $0.00 | $11.99 | Complete |  | 2019-10-25 | EEF/CU
Bason BO-4 Battery Charger | 4 bay compact battery charger | 1850 Battery Store |  | https://www.18650batterystore.com/Basen-p/basen-bo-4.htm | 2 | $14.99 | $9.81 | $1.50 | $38.29 | Complete |  | 2019-10-25 | EEF/CU
FIT0185 Brushless DC Motor | Metal DC Geared Motor w/Encoder | Arrow |  | https://www.arrow.com/en/products/fit0185/dfrobot | 2 | $28.94 | $23.98 | $11.58 | $70.28 | Complete |  | 2019-10-25 | EEF/CU
Jumper Wires (M/M, 20 Pack) | Jumper Wires - Connected 6" (M/M, 20 Pack) | Sparkfun |  | https://www.sparkfun.com/products/12795 | 1 | $1.95 | $0.00 | $0.00 | $1.95 | Complete |  | 2019-10-30 | EEF/CU
Jumper Wires (M/F, 20 Pack) | Jumper Wires - Connected 6" (M/F, 20 Pack) | Sparkfun |  | https://www.sparkfun.com/products/12794 | 1 | $1.95 | $0.00 | $0.00 | $1.95 | Complete |  | 2019-10-30 | EEF/CU
Jumper Wires (F/F, 20 Pack) | Jumper Wires - Connected 6" (F/F, 20 Pack) | Sparkfun |  | https://www.sparkfun.com/products/12796 | 1 | $1.95 | $0.00 | $0.00 | $1.95 | Complete |  | 2019-10-30 | EEF/CU
N-Channel MOSFET 60V 30A | N-Channel MOSFET 60V 30A | Sparkfun |  | https://www.sparkfun.com/products/10213 | 20 | $0.95 | $0.00 | $0.00 | $19.00 | Complete |  | 2019-10-30 | EEF/CU
Solenoid Push Pulse 5V (Latching) | Solenoid Push Pulse 5V (Latching) | Digikey |  | https://www.digikey.com/product-detail/en/delta-electronics/DSMS-0730-05/1144-1315-ND/5214006 | 1 | $27.80 | $8.99 | $0.00 | $36.79 | Complete |  | 2019-11-08 | EEF/CU
L Series Timing Belt | L Series Timing Belt | McMaster-Carr | 187L050 | https://www.mcmaster.com/6484k146 | 1 | $0.00 | $0.00 | $0.00 | $0.00 | Complete |  | 2019-11-07 | EEF/CU
Rotary shaft – straight | Rotary shaft – straight | Misumi | NSFHR15-310 | https://us.misumi-ec.com/vona2/detail/110300086920/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 | 1 | $0.00 | $0.00 | $0.00 | $0.00 | Complete |  | 2019-11-08 | EEF/CU
Idler Pulleys - Flat - Flanged | Idler Pulleys - Flat - Flanged | Misumi | TPBSN70-28 | https://us.misumi-ec.com/vona2/detail/110300412670/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 | 4 | $0.00 | $0.00 | $0.00 | $0.00 | Complete |  | 2019-11-08 | EEF/CU
EasyVR 3 Plus Shield for Arduino | Voice Recognition Module | Sparkfun |  | https://www.sparkfun.com/products/15453 | 1 | $49.95 | $0.00 | $0.00 | $49.95 | Complete |  | 2019-11-14 | EEF/CU
1/2" Drive Shaft | 1/2" Drive Shaft | McMaster Carr | 1346K17 | https://www.mcmaster.com/1346k17 | 2 | $0.00 | $0.00 | $0.00 | $0.00 | Complete |  | 2019-10-30 | Tensentric
Aluminum Framing (5 ft) | Aluminum Framing (5 ft) | McMaster Carr | 47065T101 | https://www.mcmaster.com/47065t101 | 1 | $0.00 | $0.00 | $0.00 | $0.00 | Complete |  | 2019-10-30 | Tensentric
Bracket for Framing | Bracket for Framing | McMaster Carr | 47065T267 | https://www.mcmaster.com/47065t267 | 4 | $0.00 | $0.00 | $0.00 | $0.00 | Complete |  | 2019-10-30 | Tensentric
Framing Fasteners | Framing Fasteners | McMaster Carr | 47065T142 | https://www.mcmaster.com/47065t142 | 10 | $0.00 | $0.00 | $0.00 | $0.00 | Complete |  | 2019-10-30 | Tensentric
Ratchet Gear | Ratchet Gear | McMaster Carr | 6283K22 | https://www.mcmaster.com/6283k22 | 1 | $0.00 | $0.00 | $0.00 | $0.00 | Complete |  | 2019-10-30 | Tensentric
Pawl | Pawl | McMaster Carr | 6283K32 | https://www.mcmaster.com/6283k32 | 1 | $0.00 | $0.00 | $0.00 | $0.00 | Complete |  | 2019-10-30 | Tensentric
Shoulder Screw - For Pawl | Shoulder Screw - For Pawl | McMaster Carr | 91259A469 | https://www.mcmaster.com/91259a469 | 1 | $0.00 | $0.00 | $0.00 | $0.00 | Complete |  | 2019-10-30 | Tensentric
Wing Nut for Shoulder Screw | Wing Nut for Shoulder Screw | McMaster Carr | 98671A150 | https://www.mcmaster.com/98671a150 | 1 | $0.00 | $0.00 | $0.00 | $0.00 | Complete |  | 2019-10-30 | Tensentric
Shaft Collar Large | Shaft Collar Large | McMaster Carr | 9677T21 | https://www.mcmaster.com/9677t21 | 1 | $0.00 | $0.00 | $0.00 | $0.00 | Complete |  | 2019-10-30 | Tensentric
Bearing Blocks | Bearing Blocks | McMaster Carr | 5913K61 | https://www.mcmaster.com/5913k61 | 2 | $0.00 | $0.00 | $0.00 | $0.00 | Complete |  | 2019-10-30 | Tensentric
Timing Belt Pulley | Timing Belt Pulley | McMaster Carr | 1304N11 | https://www.mcmaster.com/1304n11 | 2 | $0.00 | $0.00 | $0.00 | $0.00 | Complete |  | 2019-10-30 | Tensentric
Timing Belt | Timing Belt | McMaster Carr | 6484K144 | https://www.mcmaster.com/6484k144 | 1 | $0.00 | $0.00 | $0.00 | $0.00 | Complete |  | 2019-10-30 | Tensentric
Aluminum Side Wall (Sheet Metal) | Aluminum Side Wall (Sheet Metal) | McMaster Carr | 89015K238 | https://www.mcmaster.com/89015k238 | 1 | $0.00 | $0.00 | $0.00 | $0.00 | Complete |  | 2019-10-30 | Tensentric
Aluminum Base (Sheet Metal) | Aluminum Base (Sheet Metal) | McMaster Carr | 89015K18 | https://www.mcmaster.com/89015k18 | 1 | $0.00 | $0.00 | $0.00 | $0.00 | Complete |  | 2019-10-30 | Tensentric
Rotary Spring (Variable Force) | Rotary Spring (Variable Force) | McMaster Carr | 1846N3 | https://www.mcmaster.com/1846n3 | 2 | $0.00 | $0.00 | $0.00 | $0.00 | Complete |  | 2019-10-30 | Tensentric
3-Phase Brushless DC Mtr Driver | 3-Phase Brushless DC Mtr Driver | Digikey |  | https://www.digikey.com/product-detail/en/texas-instruments/DRV8313PWPR/296-40072-1-ND/5177949 | 5 | $3.11 | $0.00 | $0.00 | $15.55 | Complete |  | 2019-10-30 | Tensentric
3-Phase BLDC | 3-Phase BLDC | Digikey |  | https://www.digikey.com/product-detail/en/texas-instruments/DRV83053QPHPRQ1/296-44255-1-ND/6109009 | 5 | $5.95 | $0.00 | $0.00 | $29.75 | Complete |  | 2019-10-30 | Tensentric
Motor Controller | Motor Controller | Digikey |  | https://www.digikey.com/products/en?mpart=DRV8313EVM&v=296 | 1 | $102.80 | $0.00 | $0.00 | $102.80 | Complete |  | 2019-10-30 | Tensentric
Motor BLDC | Motor BLDC | Flipsky |  | https://flipsky.net/collections/e-skateboard/products/brushless-dc-motor-h5065-200kv-1650w | 1 | $64.00 | $0.00 | $0.00 | $64.00 | Complete |  | 2019-11-08 | Tensentric
3-Phase Motor Drive BoosterPack | DRV8305N 3-Phase Motor Drive BoosterPack Evaluation Module | Digikey |  | https://www.digikey.com/product-detail/en/texas-instruments/BOOSTXL-DRV8305EVM/296-43181-ND/5761583 | 1 | $82.03 | $0.00 | $0.00 | $82.03 | Complete |  | 2019-11-20 | Tensentric
C2000 Piccolo LaunchPad Microcontroller | C2000 Piccolo LaunchPad LAUNCHXL-F2069M | Digikey |  | https://www.digikey.com/product-detail/en/texas-instruments/LAUNCHXL-F28069M/296-38832-ND/5138373 | 1 | $25.95 | $0.00 | $0.00 | $25.95 | Complete |  | 2019-11-20 | Tensentric
Phase 2: Iteration 1/Manufacturing (i.e. Bill of Materials)
Item # | Description | Vendor | Part No. | Website Link (optional) | Quantity | Price Per Unit | Shipping (Est) | Discount | Total (Est) | Status (i.e. ready, ordered, complete, etc) | Lead Time | Need by | Funded by
1/2" Drive Shaft | 1/2" Drive Shaft | McMaster Carr | 1346K17 | https://www.mcmaster.com/1346k17 | 2 | $8.55 | $0.00 | $0.00 | $17.10 | Complete |  | 2019-10-30 | Tensentric
Aluminum Framing (5 ft) | Aluminum Framing (5 ft) | McMaster Carr | 47065T101 | https://www.mcmaster.com/47065t101 | 1 | $16.28 | $0.00 | $0.00 | $16.28 | Complete |  | 2019-10-30 | Tensentric
Bracket for Framing | Bracket for Framing | McMaster Carr | 47065T267 | https://www.mcmaster.com/47065t267 | 4 | $7.62 | $0.00 | $0.00 | $30.48 | Complete |  | 2019-10-30 | Tensentric
Framing Fasteners | Framing Fasteners | McMaster Carr | 47065T142 | https://www.mcmaster.com/47065t142 | 10 | $2.30 | $0.00 | $0.00 | $23.00 | Complete |  | 2019-10-30 | Tensentric
Ratchet Gear | Ratchet Gear | McMaster Carr | 6283K22 | https://www.mcmaster.com/6283k22 | 1 | $57.99 | $0.00 | $0.00 | $57.99 | Complete |  | 2019-10-30 | Tensentric
Pawl | Pawl | McMaster Carr | 6283K32 | https://www.mcmaster.com/6283k32 | 1 | $48.48 | $0.00 | $0.00 | $48.48 | Complete |  | 2019-10-30 | Tensentric
Shoulder Screw - For Pawl | Shoulder Screw - For Pawl | McMaster Carr | 91259A469 | https://www.mcmaster.com/91259a469 | 1 | $3.52 | $0.00 | $0.00 | $3.52 | Complete |  | 2019-10-30 | Tensentric
Wing Nut for Shoulder Screw | Wing Nut for Shoulder Screw | McMaster Carr | 98671A150 | https://www.mcmaster.com/98671a150 | 1 | $4.90 | $0.00 | $0.00 | $4.90 | Complete |  | 2019-10-30 | Tensentric
Shaft Collar Large | Shaft Collar Large | McMaster Carr | 9677T21 | https://www.mcmaster.com/9677t21 | 1 | $12.30 | $0.00 | $0.00 | $12.30 | Complete |  | 2019-10-30 | Tensentric
Bearing Blocks | Bearing Blocks | McMaster Carr | 5913K61 | https://www.mcmaster.com/5913k61 | 2 | $10.95 | $0.00 | $0.00 | $21.90 | Complete |  | 2019-10-30 | Tensentric
Timing Belt Pulley | Timing Belt Pulley | McMaster Carr | 1304N11 | https://www.mcmaster.com/1304n11 | 2 | $22.89 | $0.00 | $0.00 | $45.78 | Complete |  | 2019-10-30 | Tensentric
Timing Belt | Timing Belt | McMaster Carr | 6484K144 | https://www.mcmaster.com/6484k144 | 1 | $9.37 | $0.00 | $0.00 | $9.37 | Complete |  | 2019-10-30 | Tensentric
Aluminum Side Wall (Sheet Metal) | Aluminum Side Wall (Sheet Metal) | McMaster Carr | 89015K238 | https://www.mcmaster.com/89015k238 | 1 | $48.50 | $0.00 | $0.00 | $48.50 | Complete |  | 2019-10-30 | Tensentric
Aluminum Base (Sheet Metal) | Aluminum Base (Sheet Metal) | McMaster Carr | 89015K18 | https://www.mcmaster.com/89015k18 | 1 | $27.21 | $0.00 | $0.00 | $27.21 | Complete |  | 2019-10-30 | Tensentric
Rotary Spring (Variable Force) | Rotary Spring (Variable Force) | McMaster Carr | 1846N3 | https://www.mcmaster.com/1846n3 | 2 | $3.23 | $0.00 | $0.00 | $6.46 | Complete |  | 2019-10-30 | Tensentric
L Series Timing Belt | L Series Timing Belt | McMaster-Carr | 187L050 | https://www.mcmaster.com/6484k146 | 1 | $11.27 | $7.68 | $0.00 | $18.95 | Complete |  | 2019-11-07 | EEF/CU
Rotary shaft – straight | Rotary shaft – straight | Misumi | NSFHR15-310 | https://us.misumi-ec.com/vona2/detail/110300086920/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 | 1 | $14.47 | $30.04 | $0.00 | $44.51 | Complete |  | 2019-11-08 | EEF/CU
Idler Pulleys - Flat - Flanged | Idler Pulleys - Flat - Flanged | Misumi | TPBSN70-28 | https://us.misumi-ec.com/vona2/detail/110300412670/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 | 4 | $14.98 | $0.00 | $0.00 | $59.92 | Complete |  | 2019-11-08 | EEF/CU
Harness | Harness | TBD |  | TBD | 1 | $55.00 | $0.00 | $0.00 | $55.00 | Not Ready |  | 2019-01-13 | TBD
Buckles | Buckles | TBD |  | TBD | 1 | $10.00 | $0.00 | $0.00 | $10.00 | Not Ready |  | 2019-01-13 | TBD
Thing Steel Plates | Thing Steel Plates | TBD |  | TBD | 1 | $30.00 | $0.00 | $0.00 | $30.00 | Not Ready |  | 2019-01-13 | TBD
Cooling Material | Cooling Material | TBD |  | TBD | 1 | $35.00 | $0.00 | $0.00 | $35.00 | Not Ready |  | 2019-01-13 | TBD
Sewing Kit | Sewing Kit | TBD |  | TBD | 1 | $8.00 | $0.00 | $0.00 | $8.00 | Not Ready |  | 2019-01-13 | TBD
Extra Material for Loops | Extra Material for Loops | TBD |  | TBD | 1 | $12.00 | $0.00 | $0.00 | $12.00 | Not Ready |  | 2019-01-13 | TBD
3D Printing Materials | 3D Printing Materials | TBD |  | TBD | 1 | $100.00 | $0.00 | $0.00 | $100.00 | Not Ready |  | 2019-01-13 | TBD
D shape SC 1 1/4 | D shape SC 1 1/4 | Misumi | U-SSCDN1.25 | Misumi | 2 | $29.21 | $0.00 | $0.00 | $58.42 | 1x Complete, 1x Ordered |  | 2020-01-13 | EEF
D shape SC 1" | D shape SC 1" | Misumi | U-SSCDN1.00 | Misumi | 2 | $25.95 | $0.00 | $0.00 | $51.90 | Complete |  | 2020-01-13 | EEF
D shape 10 mm | D shape 10 mm | Misumi | SDNA10 | Misumi | 2 | $16.60 | $0.00 | $0.00 | $33.20 | Complete |  | 2020-01-13 | EEF
D shape 20 mm | D shape 20 mm | Misumi | SDNA20 | Misumi | 2 | $20.76 | $0.00 | $0.00 | $41.52 | Complete |  | 2020-01-13 | EEF
t slot | t slot | McMaster-Carr | 47065T101 | https://www.mcmaster.com/47065t101-47065T411 | 1 | $10.00 | $0.00 | $0.00 | $10.00 | Complete |  | 2020-01-13 | EEF
corner bracket | corner bracket | McMaster-Carr | 47065T236 | https://www.mcmaster.com/47065t236 | 4 | $5.21 | $0.00 | $0.00 | $20.84 | Complete |  | 2020-01-13 | EEF
t slot fastener | t slot fastener | McMaster-Carr | 47065T142 | https://www.mcmaster.com/47065t142 | 10 | $2.30 | $0.00 | $0.00 | $23.00 | Complete |  | 2020-01-13 | EEF
top bracket | top bracket | McMaster-Carr | 8982K63 | https://www.mcmaster.com/8982k63-8982K631 | 2 | $23.21 | $0.00 | $0.00 | $46.42 | Complete |  | 2020-01-13 | EEF
metal plates | metal plates | Midwest Supply | N/A | https://www.midweststeelsupply.com/store/6061aluminumsheet | 1 | $0.00 | $0.00 | $0.00 | $0.00 | Complete |  | 2020-01-13 | EEF
allen set | allen set | McMaster-Carr | 5709A51 | https://www.mcmaster.com/5709a51 | 1 | $6.79 | $0.00 | $0.00 | $6.79 | Complete |  | 2020-01-13 | EEF
BEARING | BEARING | sdp-si | A7Y55P11250 | http://shop.sdp-si.com/catalog/product/?id=A%207Y55-P11250 | 2 | $18.72 | $0.00 | $0.00 | $37.44 | Complete |  | 2020-01-13 | EEF
L series timing belt | L series timing belt | McMaster-Carr | 6484K145 | https://www.mcmaster.com/6484k145 | 1 | $10.38 | $0.00 | $0.00 | $10.38 | Complete |  | 2020-01-13 | EEF
bearing housing | bearing housing | Online Metals | N/A | https://www.onlinemetals.com/en/buy/aluminum-rectangle-bar-6061?checkbox=on&sort=name-asc | 2 | $15.51 | $0.00 | $0.00 | $31.02 | Complete |  | 2020-01-13 | EEF
pawl bracket | pawl bracket | McMaster-Carr | 8975K578 | https://www.mcmaster.com/8975k578 | 1 | $0.95 | $0.00 | $0.00 | $0.95 | Complete |  | 2020-01-13 | EEF
bushing | bushing | McMaster-Carr | 6389K113 | https://www.mcmaster.com/6389k113 | 1 | $0.80 | $0.00 | $0.00 | $0.80 | Complete |  | 2020-01-13 | EEF
pulley belt shaft | pulley belt shaft | McMaster-Carr | 8364T5 | https://www.mcmaster.com/8364t5 | 1 | $27.22 | $0.00 | $0.00 | $27.22 | Complete |  | 2020-01-13 | EEF
pulley belt clamp | pulley belt clamp | McMaster-Carr | 9084K96 | https://www.mcmaster.com/9084k96-9084K969 | 1 | $5.03 | $0.00 | $0.00 | $5.03 | Complete |  | 2020-01-13 | EEF
bearing for motor | bearing for motor | sdp-si | N/A | http://shop.sdp-si.com/catalog/product/?id=BBXBLK-UFL2018S | 2 | $15.96 | $0.00 | $0.00 | $31.92 | Complete |  | 2020-01-13 | EEF
stepped shaft | stepped shaft | Misumi | SFAM15-50-F15-B10-P12-T15-S10-Q12 | Misumi | 4 | $12.01 | $0.00 | $0.00 | $48.04 | Complete |  | 2020-01-13 | EEF
sleeve bearing | sleeve bearing | McMaster-Carr | 6658K27 | https://www.mcmaster.com/6658k27 | 8 | $2.36 | $0.00 | $0.00 | $18.88 | Complete |  | 2020-01-13 | EEF
belt | belt | Seattle Fabrics | None | https://www.seattlefabrics.com/34-X630-Nylon-Webbing-75-yard_p_181.html | 8 | $0.75 | $0.00 | $0.00 | $6.00 | To-Order (Don't Order Yet) |  | 2020-01-13 | EEF
d ring | d ring | Seattle Fabrics | None | https://www.seattlefabrics.com/Light-Weight-Welded-D-Rings-in-Nickel-Plated-Steel_p_1074.html | 2 | $0.50 | $0.00 | $0.00 | $1.00 | To-Order (Don't Order Yet) |  | 2020-01-13 | EEF
Shaft Extender Kit | Shaft Extender Kit, For Use With 1/2" Dia. Motor Shafts | Grainger | 12N975 | https://www.grainger.com/product/DAYTON-Shaft-Extender-Kit-12N975 | 1 | $23.98 | $0.00 | $0.00 | $23.98 | Complete |  | 2020-01-13 | EEF
 |  |  |  |  |  | $0.00 | $0.00 | $0.00 | $0.00
 |  |  |  |  |  | $0.00 | $0.00 | $0.00 | $0.00
 |  |  |  |  |  | $0.00 | $0.00 | $0.00 | $0.00
 |  |  |  |  |  | $0.00 | $0.00 | $0.00 | $0.00
 |  |  |  |  |  | $0.00 | $0.00 | $0.00 | $0.00
 |  |  |  |  |  | $0.00 | $0.00 | $0.00 | $0.00
 |  |  |  |  |  | $0.00 | $0.00 | $0.00 | $0.00
 |  |  |  |  |  | $0.00 | $0.00 | $0.00 | $0.00
 |  |  |  |  |  | $0.00 | $0.00 | $0.00 | $0.00
 |  |  |  |  |  | $0.00 | $0.00 | $0.00 | $0.00
 |  |  |  |  |  | $0.00 | $0.00 | $0.00 | $0.00
 |  |  |  |  |  | $0.00 | $0.00 | $0.00 | $0.00
 |  |  |  |  |  | $0.00 | $0.00 | $0.00 | $0.00
 |  |  |  |  |  | $0.00 | $0.00 | $0.00 | $0.00
 |  |  |  |  |  | $0.00 | $0.00 | $0.00 | $0.00
Testing | Testing of Materials + Replacements |  |  |  | 1 | $400.00 | $0.00 | $0.00 | $400.00
100W 12V/24V 3000rpm BLDC Motor | 100W 12V/24V 3000rpm BLDC Motor w/ 70:1 Planetary Gearbox | ato |  | https://www.ato.com/100w-bldc-motor | 1 | $480.14 | $0.00 | $0.00 | $480.14 | Shipped |  | 2020-01-13 | EEF
C2000 Piccolo LaunchPad Microcontroller | C2000 Piccolo LaunchPad LAUNCHXL-F2069M | Digikey |  | https://www.digikey.com/product-detail/en/texas-instruments/LAUNCHXL-F28069M/296-38832-ND/5138373 | 3 | $25.95 | $0.00 | $0.00 | $77.85 | Complete |  | 2019-11-20 | Tensentric
EasyVR 3 Plus Shield for Arduino | Voice Recognition Module | Sparkfun |  | https://www.sparkfun.com/products/15453 | 1 | $49.95 | $0.00 | $0.00 | $49.95 | Complete |  | 2019-11-14 | EEF
24V 12Ah Lithium Ion Battery | 24V 12Ah Lithium Ion Battery | BixPower | KL24H93S.809 | https://www.bixpower.com/24V-10-4Ah-Battery-BX2493H-p/bat-bx2493h.htm | 1 | $289.95 | $0.00 | $0.00 | $289.95 | Complete |  | 2020-01-13 | EEF
Wired Controller PCB | Custom PCB for Wired Controller | TBD |  | TBD | 1 | $0.00 | $0.00 | $0.00 | $0.00 | Not Ready |  | 2020-01-13 | TBD
Extra Electrical Components | Wires, etc | TBD |  | TBD | 1 | $0.00 | $0.00 | $0.00 | $0.00 | Not Ready |  | 2020-01-13 | TBD
Solenoid Push Pulse 5V (Latching) | Solenoid Push Pulse 5V (Latching) | Digikey |  | https://www.digikey.com/product-detail/en/delta-electronics/DSMS-0730-05/1144-1315-ND/5214006 | 2 | $27.80 | $8.99 | $0.00 | $64.59 | Complete |  | 2019-11-08 | EEF/CU
 |  |  |  |  |  | $0.00 | $0.00 | $0.00 | $0.00
 |  |  |  |  |  | $0.00 | $0.00 | $0.00 | $0.00
 |  |  |  |  |  | $0.00 | $0.00 | $0.00 | $0.00
 |  |  |  |  |  | $0.00 | $0.00 | $0.00 | $0.00
 |  |  |  |  |  | $0.00 | $0.00 | $0.00 | $0.00
 |  |  |  |  |  | $0.00 | $0.00 | $0.00 | $0.00
Shipping | Everyone's Shipping |  |  |  | 1 | $150.00 | $0.00 | $0.00 | $150.00
BOOSTXL-DRV8305EVM Parts (Some parts may have different part number due to availability, original part number listed)
C1, C3, C9, C17 | CAP, CERM, 1 µF, 16 V, +/- 10%, X7R, 0603 | Digikey | C1608X7R1C105K | https://www.digikey.com/product-detail/en/tdk-corporation/C1608X7R1C105K080AC/445-1604-1-ND/634399 | 10 | $0.10 | $0.00 | $0.00 | $1.05 | Complete |  | 2020-01-13 | EEF
C2, C7 | CAP, CERM, 0.047uF, 100V, +/-10%, X7R, 0603 | Digikey | C0603C473K1RACTU | https://www.digikey.com/product-detail/en/kemet/C0603C473K1RACTU/399-9096-1-ND/3522613 | 10 | $0.30 | $0.00 | $0.00 | $3.04 | Complete |  | 2020-01-13 | EEF
C4, C5, C6, C20 | CAP, CERM, 1 µF, 50 V, +/- 10%, X7R, 0603 | Digikey | UMK107AB7105KA-T | https://www.digikey.com/product-detail/en/taiyo-yuden/UMK107AB7105KA-T/587-3247-6-ND/3660108 | 10 | $0.17 | $0.00 | $0.00 | $1.75 | Complete |  | 2020-01-13 | EEF
C8 | CAP, CERM, 4.7 µF, 50 V, +/- 10%, X7R, 1206 | Digikey | GRM31CR71H475KA12L | https://www.digikey.com/product-detail/en/murata-electronics/GRM31CR71H475KA12L/490-6521-6-ND/3846734 | 10 | $0.58 | $0.00 | $0.00 | $5.79 | Complete |  | 2020-01-13 | EEF
C10, C11, C12, C22 | CAP, CERM, 0.1 µF, 16 V, +/- 5%, X7R, 0603 | Digikey | C0603C104J4RACTU | https://www.digikey.com/product-detail/en/kemet/C0603C104J4RACTU/399-1097-1-ND/411372 | 10 | $0.10 | $0.00 | $0.00 | $1.00 | Complete |  | 2020-01-13 | EEF
C13, C14, C16 | CAP, CERM, 1000pF, 16V, +/-10%, X7R, 0603 | Digikey | GRM188R71C102KA01D | https://www.digikey.com/product-detail/en/walsin-technology-corporation/0603B102K160CT/1292-1378-1-ND/9355382 | 10 | $0.04 | $0.00 | $0.00 | $0.41 | Complete |  | 2020-01-13 | EEF
C15 | CAP, CERM, 2.2 µF, 100 V, +/- 10%, X7R, 1210 | Digikey | GRM32ER72A225KA35L | https://www.digikey.com/product-detail/en/murata-electronics/GRM32ER72A225KA35L/490-3385-1-ND/702926 | 10 | $1.46 | $0.00 | $0.00 | $14.55 | Complete |  | 2020-01-13 | EEF
C18, C19 | CAP, AL, 330 µF, 50 V, +/- 20%, 0.3 ohm, SMD | Digikey | EEE-FT1H331AP | https://www.digikey.com/product-detail/en/panasonic-electronic-components/EEE-FT1H331AP/PCE5026CT-ND/2652081 | 10 | $0.86 | $0.00 | $0.00 | $8.59 | Complete |  | 2020-01-13 | EEF
C21 | CAP, CERM, 22 µF, 10 V, +/- 10%, X7R, 1206 | Digikey | GRM31CR71A226KE15L | https://www.digikey.com/product-detail/en/murata-electronics/GRM31CR71A226KE15L/490-5309-1-ND/2039088 | 10 | $0.85 | $0.00 | $0.00 | $8.48 | Complete |  | 2020-01-13 | EEF
C23, C24, C25 | CAP, CERM, 2200pF, 16V, +/-10%, X7R, 0603 | Digikey | GRM188R71C222KA01D | https://www.digikey.com/product-detail/en/yageo/CC0603KRX7R7BB222/311-3652-1-ND/8024741 | 10 | $0.06 | $0.00 | $0.00 | $0.55 | Complete |  | 2020-01-13 | EEF
C26 | CAP, CERM, 0.33 µF, 16 V, +/- 10%, X7R, 0603 | Digikey | GRM188R71C334KA01D | https://www.digikey.com/product-detail/en/murata-electronics/GRM188R71C334KA01D/490-3294-1-ND/702835 | 10 | $0.14 | $0.00 | $0.00 | $1.35 | Complete |  | 2020-01-13 | EEF
D1 | LED, Red, SMD | Digikey | LTST-C170KRKT | https://www.digikey.com/product-detail/en/lite-on-inc/LTST-C170KRKT/160-1415-1-ND/386778 | 10 | $0.24 | $0.00 | $0.00 | $2.41 | Complete |  | 2020-01-13 | EEF
D2 | Transient Voltage Suppressors, 5 V, TSOP-6 | Digikey | NUP4201MR6T1G | https://www.digikey.com/product-detail/en/on-semiconductor/NUP2201MR6T1G/NUP2201MR6T1GOSCT-ND/720939 | 10 | $0.46 | $0.00 | $0.00 | $4.58 | Complete |  | 2020-01-13 | EEF
D3 | LED, Green, SMD | Digikey | LTST-C171GKT | https://www.digikey.com/product-detail/en/lite-on-inc/LTST-C171GKT/160-1423-1-ND/386792 | 10 | $0.20 | $0.00 | $0.00 | $2.01 | Complete |  | 2020-01-13 | EEF
D4 | Diode, Schottky, 100 V, 1 A, SOD-123FL | Digikey | MBR1H100SFT3G | https://www.digikey.com/product-detail/en/on-semiconductor/MBR1H100SFT3G/MBR1H100SFT3GOSCT-ND/3462287 | 10 | $0.39 | $0.00 | $0.00 | $3.86 | Complete |  | 2020-01-13 | EEF
FID1, FID2, FID3 | Fiducial mark. There is nothing to buy or mount. |  | N/A |  |  | $0.00 | $0.00 | $0.00 | $0.00 | Complete |  | 2020-01-13 | EEF
J1, J2 | Receptacle, 2.54 mm, 10x2, Gold, TH | Mouser | CRD-081413-A-G | https://www.mouser.com/ProductDetail/Samtec/SSQ-110-23-F-D | 4 | $5.99 | $0.00 | $0.00 | $23.96 | Complete |  | 2020-01-13 | Tensentric
J3 | Terminal Block, 5 mm, 2x1, Tin, TH | Digikey | 691 101 710 002 | https://www.digikey.com/products/en?keywords=TB001-500-02BE | 10 | $0.32 | $0.00 | $0.00 | $3.22 | Complete |  | 2020-01-13 | EEF
J4 | Terminal Block, 5 mm, 3x1, Tin, TH | Digikey | 691 101 710 003 | https://www.digikey.com/products/en?keywords=TB001-500-03BE | 10 | $0.43 | $0.00 | $0.00 | $4.31 | Complete |  | 2020-01-13 | EEF
L1 | Inductor, Shielded Drum Core, Ferrite, 15 µH, 1.1 A, 0.122 ohm, SMD | Digikey | SD53-150-R | https://www.digikey.com/product-detail/en/eaton-electronics-division/SD53-150-R/513-1458-1-ND/1555607 | 5 | $2.22 | $0.00 | $0.00 | $11.10 | Complete |  | 2020-01-13 | EEF
Q1, Q2, Q3, Q4, Q5, Q6 | MOSFET, N-CH, 60 V, 28 A, SON 5x6mm | Digikey | CSD18540Q5B | https://www.digikey.com/product-detail/en/texas-instruments/CSD18540Q5B/296-41076-1-ND/5181337 | 12 | $2.51 | $0.00 | $0.00 | $30.12 | Complete |  | 2020-01-13 | EEF
R1, R3 | RES, 10k ohm, 5%, 0.1W, 0603 | Digikey | CRCW060310K0JNEA | https://www.digikey.com/product-detail/en/vishay-dale/CRCW060310K0JNEA/541-10KGCT-ND/1179393 | 10 | $0.03 | $0.00 | $0.00 | $0.31 | Complete |  | 2020-01-13 | EEF
R2 | RES, 100 ohm, 5%, 0.1W, 0603 | Digikey | CRCW0603100RJNEA | https://www.digikey.com/product-detail/en/vishay-dale/CRCW0603100RJNEA/541-100GCT-ND/1179345 | 10 | $0.03 | $0.00 | $0.00 | $0.31 | Complete |  | 2020-01-13 | EEF
R4, R5, R6 | RES SMD 0.007 OHM 1% 3W 2512 | Digikey | CRE2512-FZ-R007E-3 | https://www.digikey.com/product-detail/en/bourns-inc/CRE2512-FZ-R007E-3/CRE2512-FZ-R007E-3CT-ND/4900096 | 10 | $0.70 | $0.00 | $0.00 | $7.01 | Complete |  | 2020-01-13 | EEF
R7, R15 | RES, 330 ohm, 5%, 0.1W, 0603 | Digikey | CRCW0603330RJNEA | https://www.digikey.com/product-detail/en/vishay-dale/CRCW0603330RJNEA/541-330GCT-ND/1179357 | 10 | $0.03 | $0.00 | $0.00 | $0.31 | Complete |  | 2020-01-13 | EEF
R8, R9, R10, R14 | RES, 62.0 k, 1%, 0.1 W, 0603 | Digikey | RC0603FR-0762KL | https://www.digikey.com/product-detail/en/yageo/RC0603FR-0762KL/311-62.0KHRCT-ND/730283 | 10 | $0.02 | $0.00 | $0.00 | $0.23 | Complete |  | 2020-01-13 | EEF
R11, R12, R13, R16 | RES, 4.99 k, 1%, 0.1 W, 0603 | Digikey | RC0603FR-074K99L | https://www.digikey.com/product-detail/en/yageo/RC0603FR-074K99L/311-4.99KHRCT-ND/730166 | 10 | $0.02 | $0.00 | $0.00 | $0.23 | Complete |  | 2020-01-13 | EEF
R17, R18, R19 | RES, 56 ohm, 5%, 0.1W, 0603 | Digikey | CRCW060356R0JNEA | https://www.digikey.com/product-detail/en/vishay-dale/CRCW060356R0JNEA/541-56GCT-ND/1179339 | 10 | $0.03 | $0.00 | $0.00 | $0.31 | Complete |  | 2020-01-13 | EEF
R20 | RES, 68.0 k, 1%, 0.1 W, 0603 | Digikey | RC0603FR-0768KL | https://www.digikey.com/product-detail/en/yageo/RC0603FR-0768KL/311-68.0KHRCT-ND/730299 | 10 | $0.02 | $0.00 | $0.00 | $0.23 | Complete |  | 2020-01-13 | EEF
R21 | RES, 20.0 k, 1%, 0.1 W, 0603 | Digikey | CRCW060320K0FKEA | https://www.digikey.com/product-detail/en/vishay-dale/CRCW060320K0FKEA/541-20.0KHCT-ND/1179956 | 10 | $0.03 | $0.00 | $0.00 | $0.34 | Complete |  | 2020-01-13 | EEF
U1 | Three Phase Automotive Gate Driver with Three Integrated Current Shunt Amplifiers and Voltage Regulator, PHP0048G | Digikey | DRV8305NPHPQ1 | https://www.digikey.com/product-detail/en/texas-instruments/DRV83055QPHPRQ1/296-44256-1-ND/6109010 | 4 | $5.95 | $0.00 | $0.00 | $23.80 | Complete |  | 2020-01-13 | EEF
U2 | Wide Input Voltage Range Buck Regulator with High Efficiency Sleep Mode, DDC0006A | Digikey | LMR16006XDDC | https://www.digikey.com/product-detail/en/texas-instruments/LMR16006XDDCR/296-40293-1-ND/5178170 | 4 | $2.88 | $0.00 | $0.00 | $11.52 | Complete |  | 2020-01-13 | EEF
4-Layer PCB | 4-Layer PCB | PCBWay | Custom | https://www.pcbway.com/ | 2 | $66.00 | $0.00 | $0.00 | $132.00 | Complete |  | 2020-01-13 | EEF
Phase 3: Expo
Item # | Description | Vendor | Part No. | Website Link (optional) | Quantity | Price Per Unit | Shipping (Est) | Discount | Total (Est) | Status (i.e. ready, ordered, complete, etc) | Lead Time | Need by | Funded by
Expo Materials | Includes posters, prints, etc | TBD |  | TBD | 1 | $50.00 | $0.00 | $0.00 | $50.00
 |  |  |  |  |  | $0.00 | $0.00 | $0.00 | $0.00
 |  |  |  |  |  | $0.00 | $0.00 | $0.00 | $0.00
 |  |  |  |  |  | $0.00 | $0.00 | $0.00 | $0.00
 |  |  |  |  |  | $0.00 | $0.00 | $0.00 | $0.00
 |  |  |  |  |  | $0.00 | $0.00 | $0.00 | $0.00
Client Interactions
Item # | Description | Vendor | Part No. | Website Link (optional) | Quantity | Price Per Unit | Shipping (Est) | Discount | Total (Est) | Status (i.e. ready, ordered, complete, etc) | Lead Time | Need by | Funded by
 |  |  |  |  |  | $0.00 | $0.00 | $0.00 | $0.00
 |  |  |  |  |  | $0.00 | $0.00 | $0.00 | $0.00
 |  |  |  |  |  | $0.00 | $0.00 | $0.00 | $0.00
 |  |  |  |  |  | $0.00 | $0.00 | $0.00 | $0.00
 |  |  |  |  |  | $0.00 | $0.00 | $0.00 | $0.00
 |  |  |  |  |  | $0.00 | $0.00 | $0.00 | $0.00
