danielfu11/exoseat/ProjectPlanning/Diagrams/powerpcb.pdf

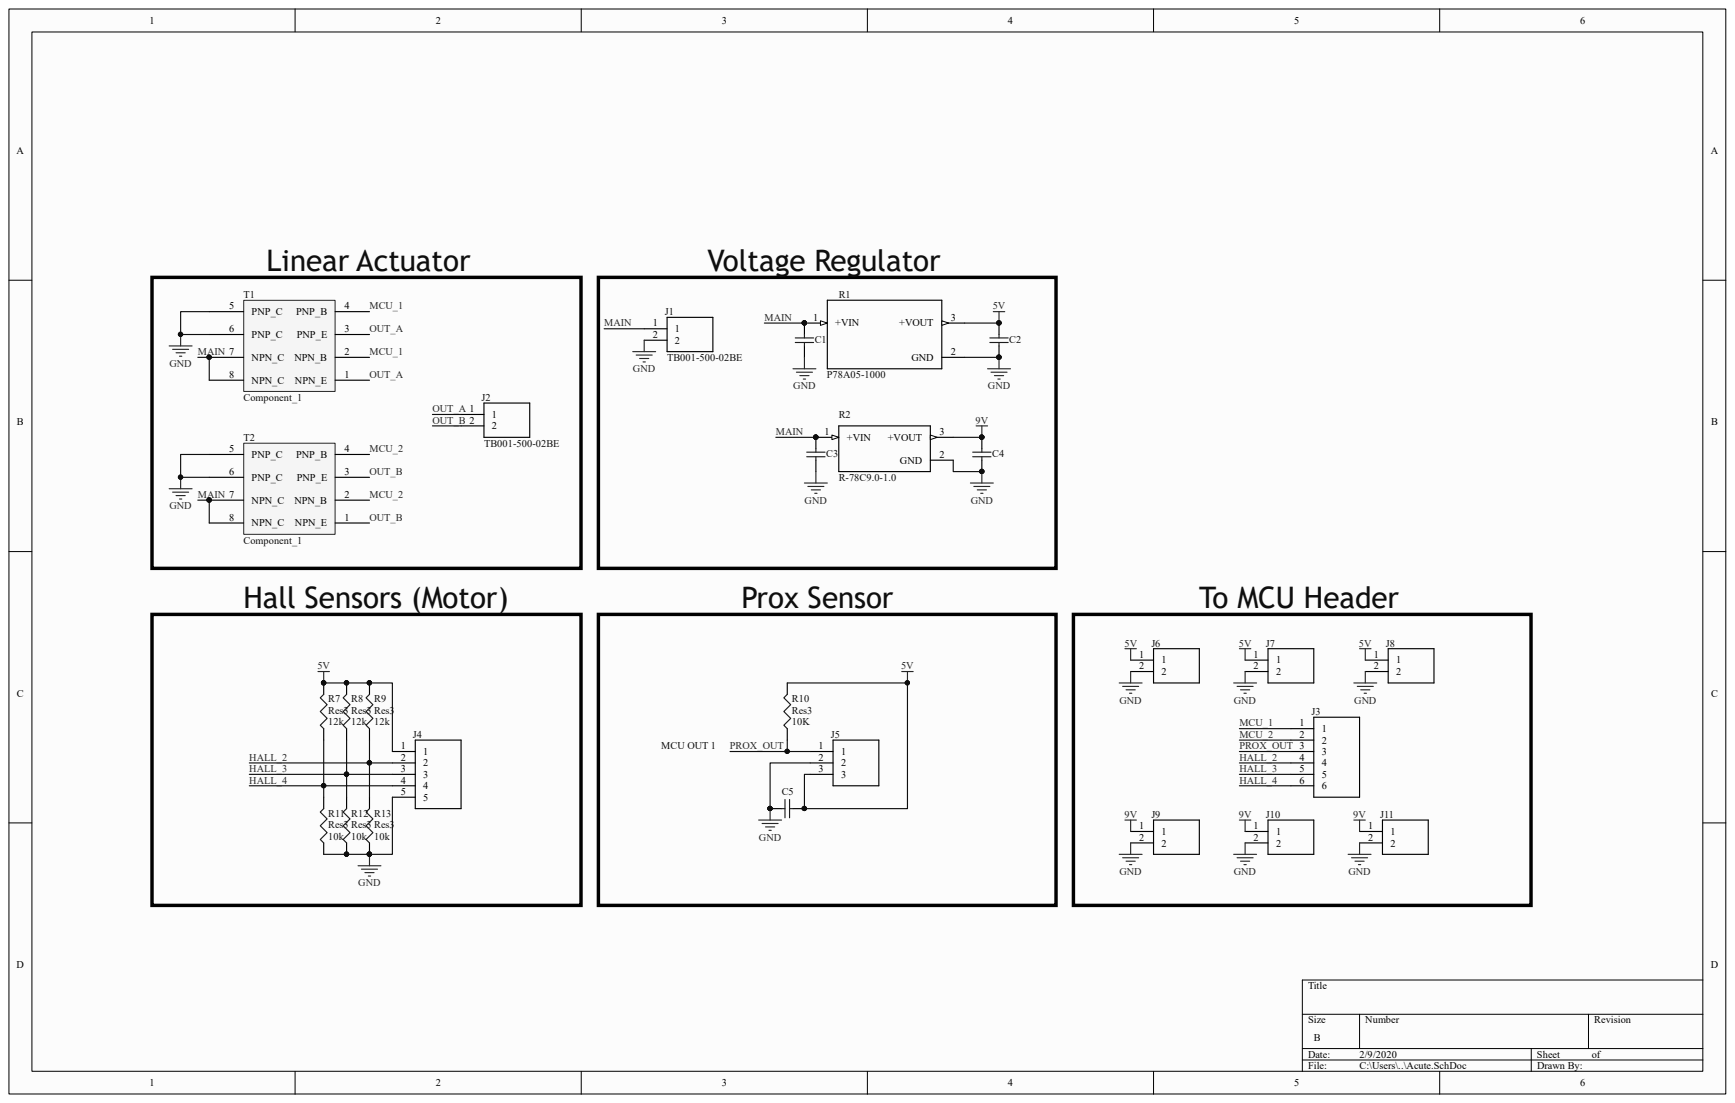
[picture p4: page 1]
