danielfu11/exoseat/ProjectPlanning/Diagrams/motordriver_v1.pdf

# PVDD1 2

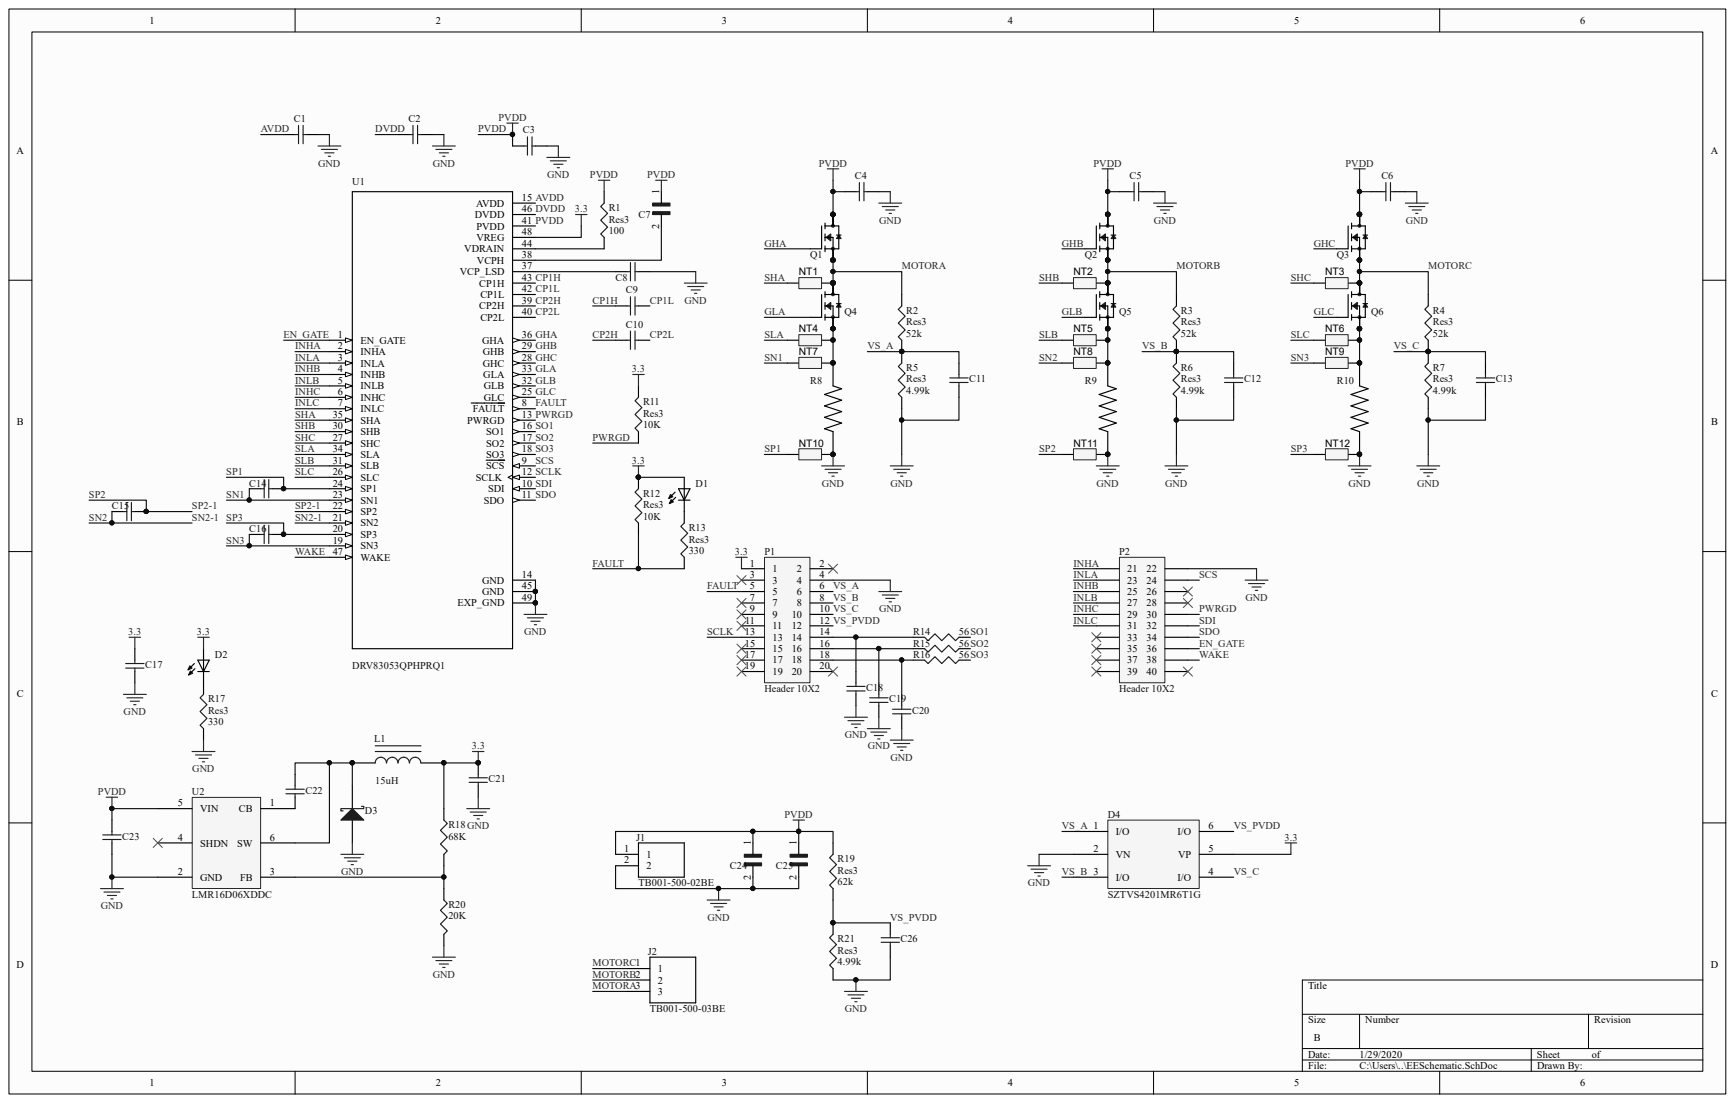
[picture p5: page 1]
