danielfu11/exoseat/Final/inc/user_control.h

/*
 * user_control.h
 *
 *  Created on: Mar 1, 2020
 *      Author: sonya
 */

#ifndef INC_USER_CONTROL_H_
#define INC_USER_CONTROL_H_

void usr_ctrl_comm_init(void);
void usr_ctrl_send_msg(Uint16 data);



#endif /* INC_USER_CONTROL_H_ */
