danielfu11/exoseat/Final/inc/prox_sense.h

/*
 * prox_sense.h
 *
 *  Created on: Mar 11, 2020
 *      Author: sonya
 */

#include "stdbool.h"

#ifndef INC_PROX_SENSE_H_
#define INC_PROX_SENSE_H_

void hall_prox_sense_init(void);
bool poll_prox_sense(void);


#endif /* INC_PROX_SENSE_H_ */
