danielfu11/exoseat/(commit log)

2019-11-07 Add prototype directory
2019-12-04 Added Configuration Management and Version History docs
    [ConfigurationManagment.txt]
2020-01-29 Uploading motordriver sch.
2020-02-05 Initial motor drive firmware working, using independent PWM, need to implement complementary PWM
2020-02-07 Added solenoid drive code (not tested)
2020-02-10 Budget Tracker as of 2/9/20. The Actual tab is up-to-date.
    [Team_31_Budget_Tracker.xlsx]
2020-02-10 Power PCB pdf
2020-02-15 working motor (not stopping)
2020-02-15 Fix speed measurement code
    [hallsensor.c, timer.c]
2020-02-26 source and include files only
    [ConfigurationManagment.txt]
2020-03-01 added mysteriously missing header files...
    [drv8305_config.h, hallsensor.h, solenoid_drive.h]
2020-04-23 added state machine, user control interface, and prox hall sensor code
2020-04-23 prox hall sensor, state machine, and user control header files
2020-04-27 re-add documentation files to GitLab
    [ConfigurationManagement.txt]
2020-04-28 Adding Voice Control + Wired Remote Directory
